uk-ux/inmoov-iris/hardware/assembly-references/head_32.png

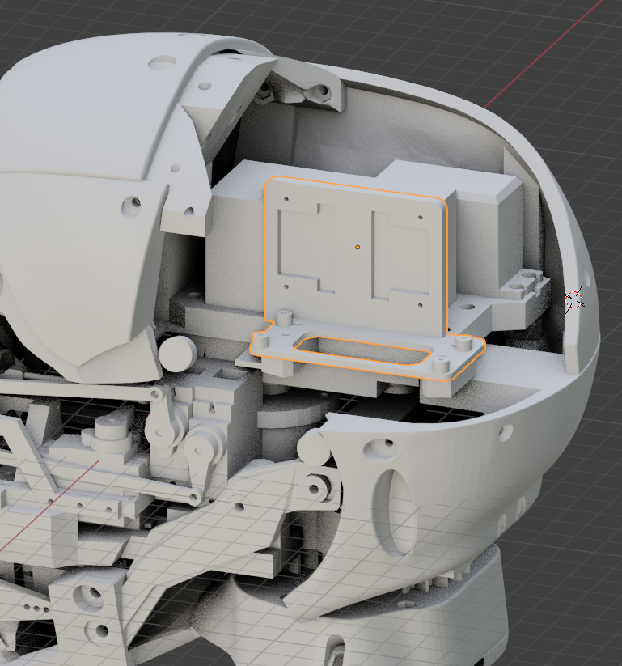
hardware/assembly-references/head_32.png
