uk-ux/inmoov-iris/hardware/assembly-references/head_11.png

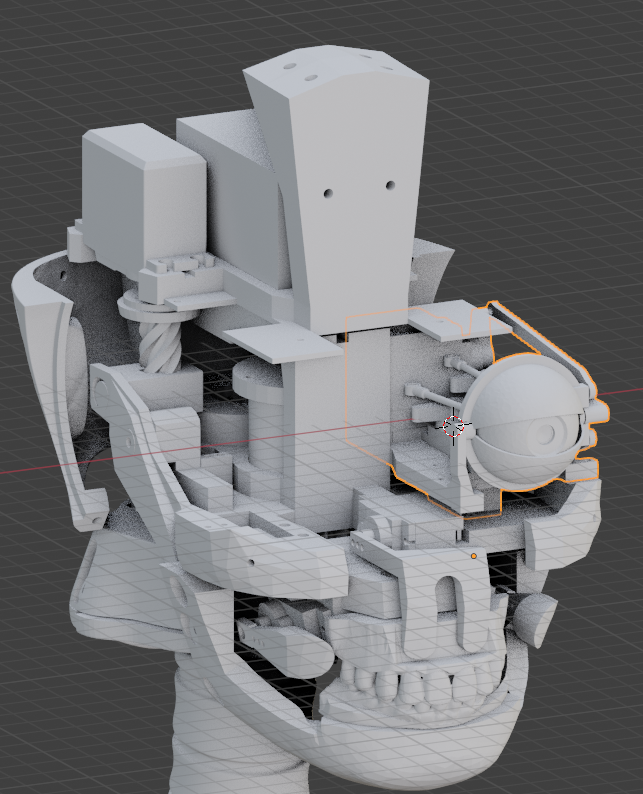
hardware/assembly-references/head_11.png
