uk-ux/inmoov-iris/hardware/i2eyes-source.html

# InMoov body parts library : i2Eyes

 (http://creativecommons.org/licenses/by-nc/3.0/)

INMOOV Eye-L-AllPartsV2.stl
Download Eye-L-AllPartsV2.stl

INMOOV Eye-L-BaseV5.stl
Download Eye-L-BaseV5.stl

INMOOV Eye-R-AllPartsV2.stl
Download Eye-R-AllPartsV2.stl

INMOOV Eye-R-BaseV5.stl
Download Eye-R-BaseV5.stl

### Press Release Discover InMoov Press Release all other the World (https://www.inmoov.fr/on-the-net/)
