uk-ux/inmoov-iris/hardware/i2head-source.html

# InMoov body parts library : i2Head

 (http://creativecommons.org/licenses/by-nc/3.0/)

INMOOV BottomTeethV1.stl
Download BottomTeethV1.stl

INMOOV CheekPullerV3.stl
Download CheekPullerV3.stl

INMOOV EarLockV1.stl
Download EarLockV1.stl

INMOOV EyebrowSupportV3.stl
Download EyebrowSupportV3.stl

INMOOV EyebrowV3.stl
Download EyebrowV3.stl

INMOOV FaceHolderLeftV5.stl
Download FaceHolderLeftV5.stl

INMOOV FaceHolderRightV5.stl
Download FaceHolderRightV5.stl

INMOOV ForHeadSupportV2.stl
Download ForHeadSupportV2.stl

INMOOV ForHeadsV4.stl
Download ForHeadsV4.stl

INMOOV GearHolderV3.stl
Download GearHolderV3.stl

INMOOV InnerMiddleMoldV1.stl
Download InnerMiddleMoldV1.stl

INMOOV InnerSidesMoldV1.stl
Download InnerSidesMoldV1.stl

INMOOV JawHingeV4.stl
Download JawHingeV4.stl

INMOOV JawPistonV1NoSupport.stl
Download JawPistonV1NoSupport.stl

INMOOV JawSupportV2.stl
Download JawSupportV2.stl

INMOOV JawV5.stl
Download JawV5.stl

INMOOV LowBackV5.stl
Download LowBackV5.stl

INMOOV MainGearV2.stl
Download MainGearV2.stl

INMOOV OuterBottomMoldFemaleV2.stl
Download OuterBottomMoldFemaleV2.stl

INMOOV OuterBottomMoldMaleV2.stl
Download OuterBottomMoldMaleV2.stl

INMOOV OuterTopMoldFemaleV1.stl
Download OuterTopMoldFemaleV1.stl

INMOOV OuterTopMoldMaleV1.stl
Download OuterTopMoldMaleV1.stl

INMOOV PCA9685ConnectV2.stl
Download PCA9685ConnectV2.stl

INMOOV PCA9685supportV1.stl
Download PCA9685supportV1.stl

INMOOV RingV2.stl
Download RingV2.stl

INMOOV ServoGearV2.stl
Download ServoGearV2.stl

INMOOV SkullServoFixV5.stl
Download SkullServoFixV5.stl

INMOOV TeethTopHolderV3.stl
Download TeethTopHolderV3.stl

INMOOV TopBackskullV4.stl
Download TopBackskullV4.stl

INMOOV TopTeethV3.stl
Download TopTeethV3.stl

INMOOV TopskullFrontV1.stl
Download TopskullFrontV1.stl

INMOOV TopskullV5.stl
Download TopskullV5.stl

INMOOV UpperLipV2.stl
Download UpperLipV2.stl

INMOOV servoAdapterV1.stl
Download servoAdapterV1.stl

INMOOV servoHornAdapterV1.stl
Download servoHornAdapterV1.stl

### Press Release Discover InMoov Press Release all other the World (https://www.inmoov.fr/on-the-net/)
