uk-ux/inmoov-iris/hardware/topskull-reference.png

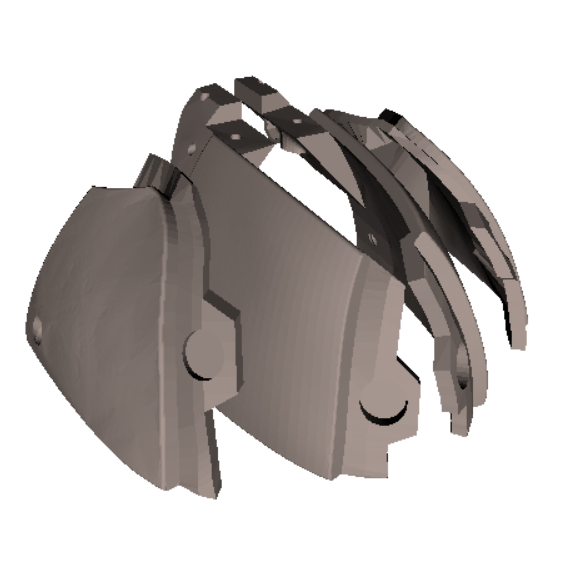
hardware/topskull-reference.png
