uk-ux/inmoov-iris/hardware/twin-isolate-preview.png

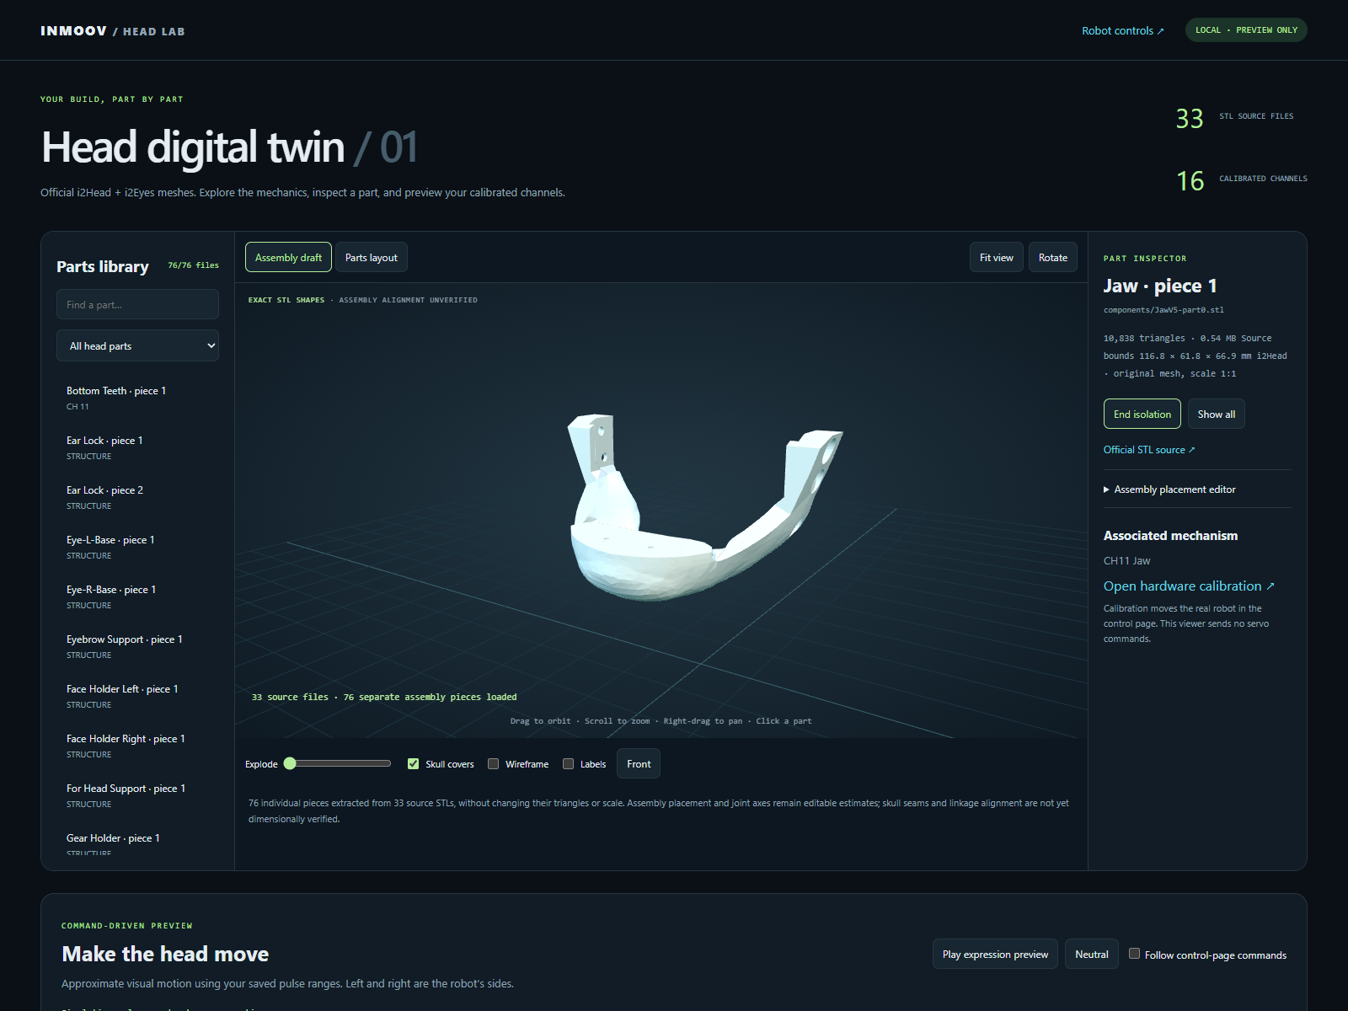
hardware/twin-isolate-preview.png
