uk-ux/inmoov-iris/hardware/twin-mobile-preview.png

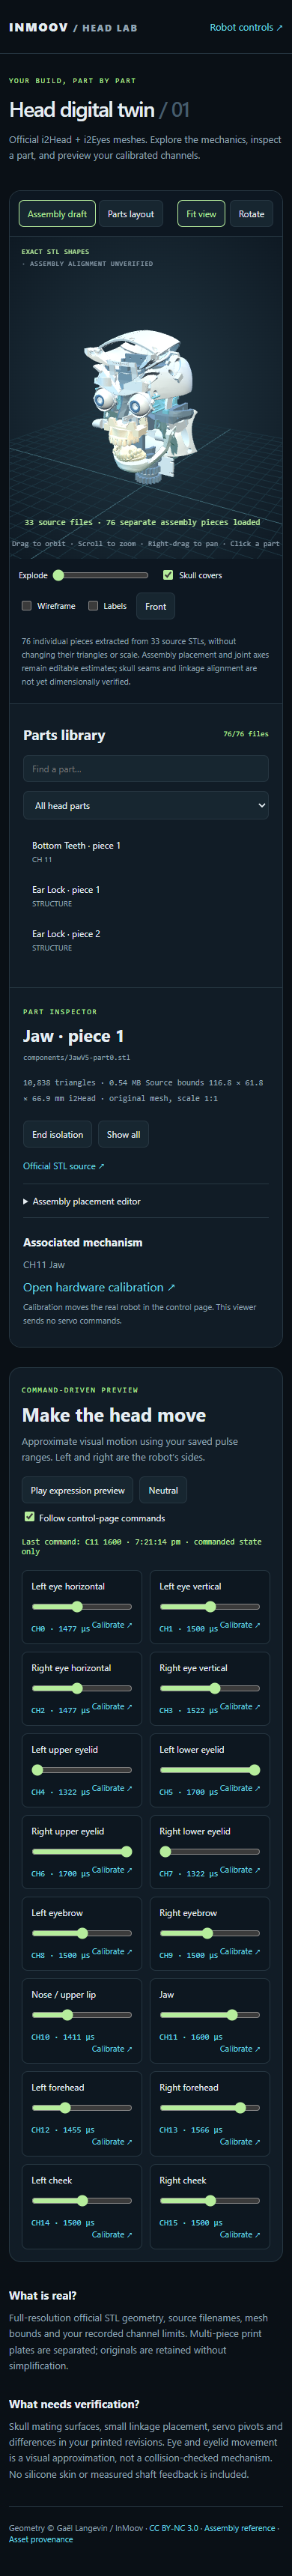
hardware/twin-mobile-preview.png
