uk-ux/inmoov-iris/hardware/twin-preview.png

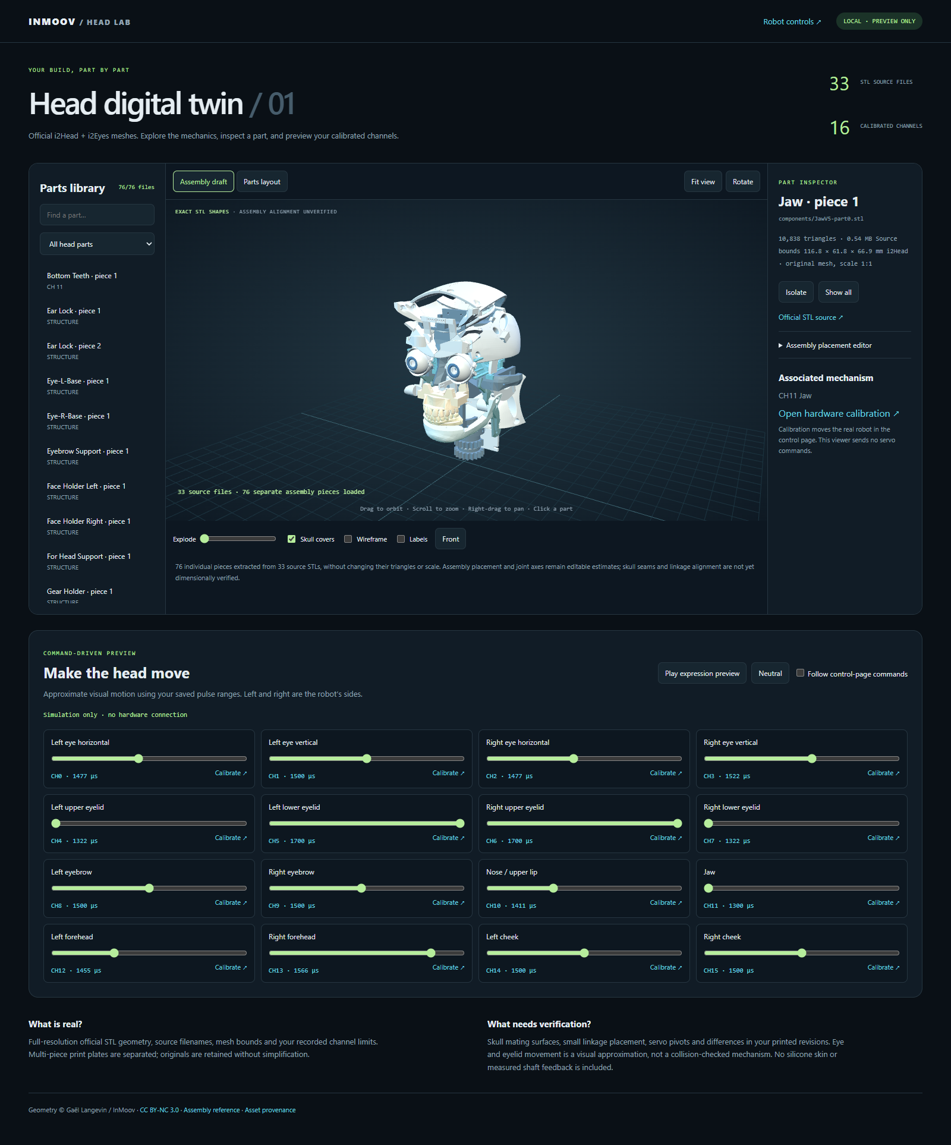
hardware/twin-preview.png
