uk-ux/inmoov-iris/hardware/component-inspect.png

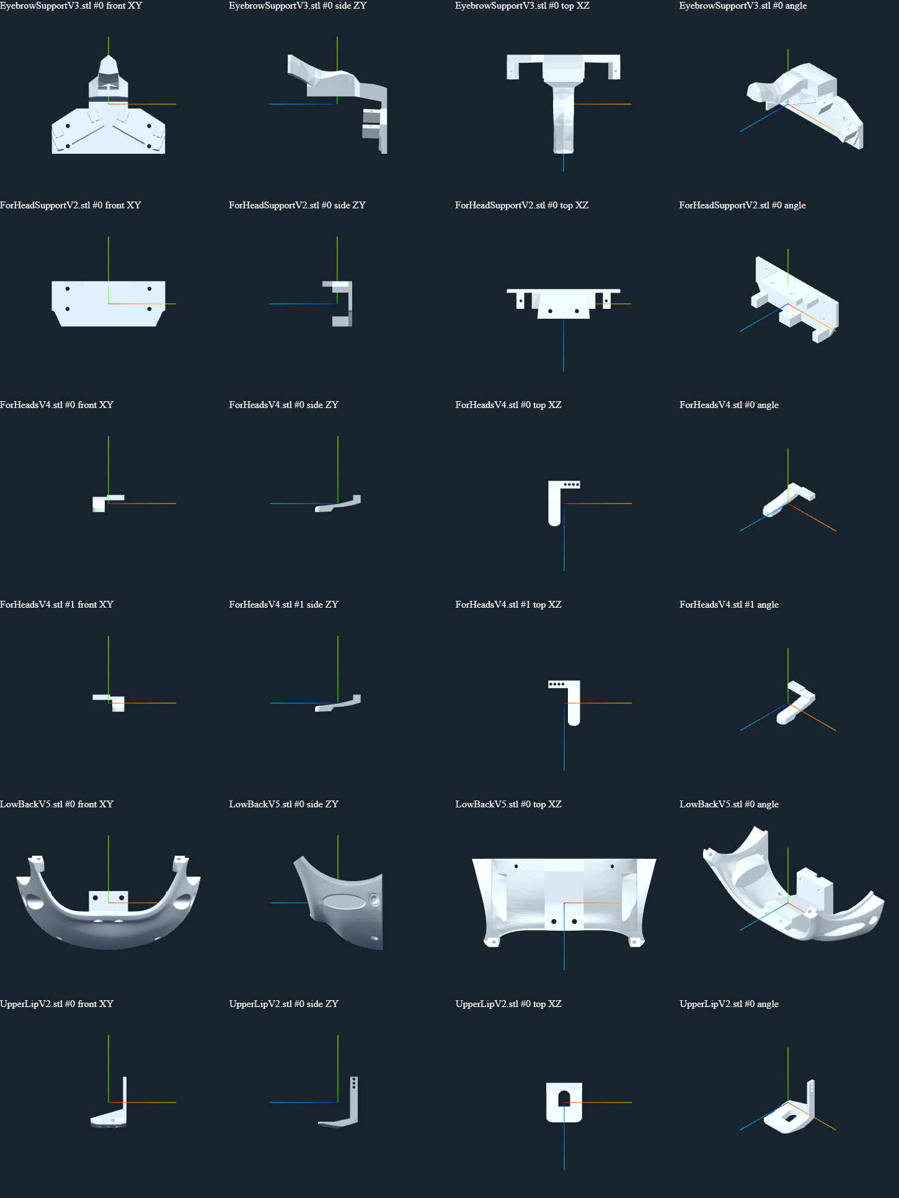
hardware/component-inspect.png
