uk-ux/inmoov-iris/control_ui/twin/assets/MainGearV2.stl

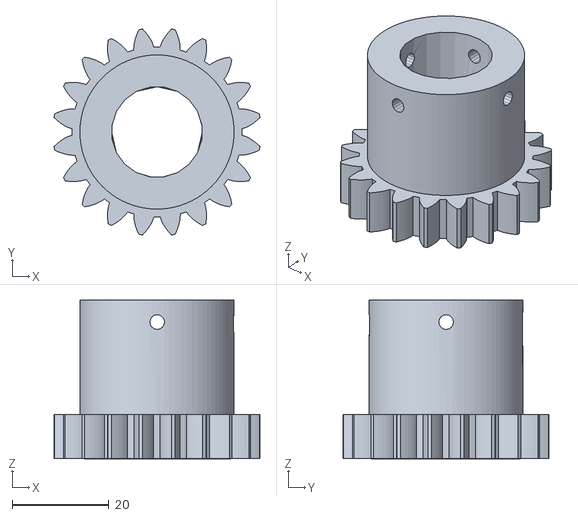
[picture p8: CAD file, 2026-09-29]
control_ui/twin/assets/MainGearV2.stl
42.7 x 42.7 x 32.8
