uk-ux/inmoov-iris/control_ui/twin/assets/components/Eye-R-AllPartsV2-part11.stl

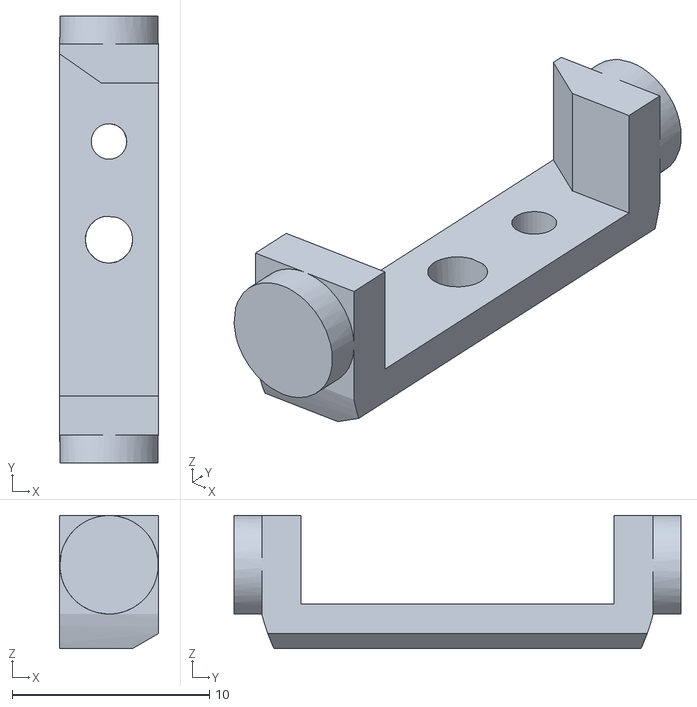
[picture p9: CAD file, 2026-09-29]
control_ui/twin/assets/components/Eye-R-AllPartsV2-part11.stl
5.00 x 22.7 x 6.75
