uk-ux/inmoov-iris/control_ui/twin/assets/PCA9685supportV1.stl

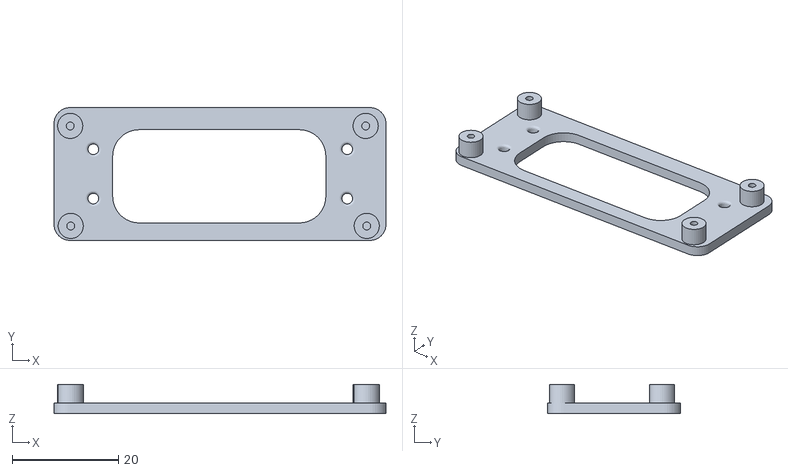
[picture p10: CAD file, 2026-09-29]
control_ui/twin/assets/PCA9685supportV1.stl
62.5 x 25.0 x 5.50
