uk-ux/inmoov-iris/control_ui/twin/assets/components/Eye-L-AllPartsV2-part7.stl

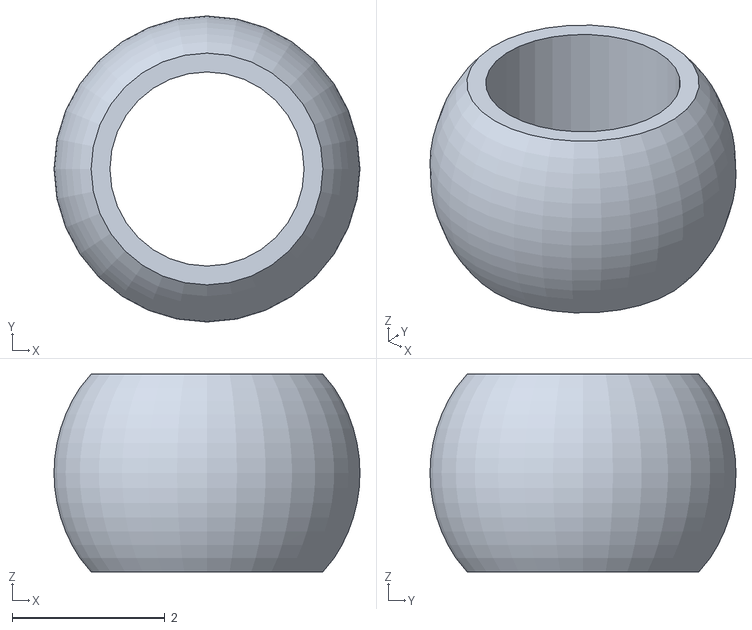
[picture p11: CAD file, 2026-09-29]
control_ui/twin/assets/components/Eye-L-AllPartsV2-part7.stl
4.00 x 4.00 x 2.59
