uk-ux/inmoov-iris/control_ui/twin/assets/LowBackV5.stl

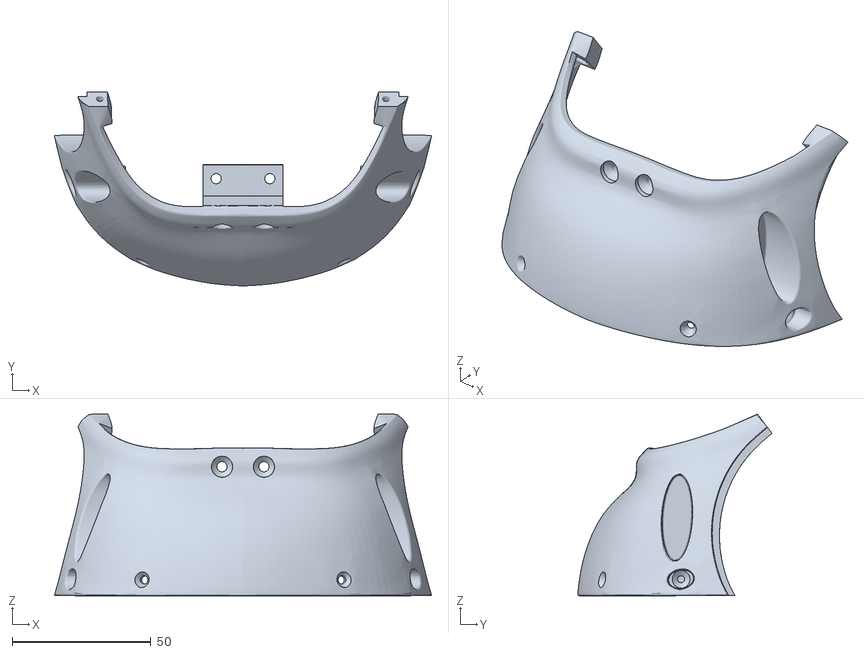
[picture p12: CAD file, 2026-09-29]
control_ui/twin/assets/LowBackV5.stl
136.1 x 70.0 x 65.6
