uk-ux/inmoov-iris/control_ui/twin/assets/components/JawV5-part0.stl

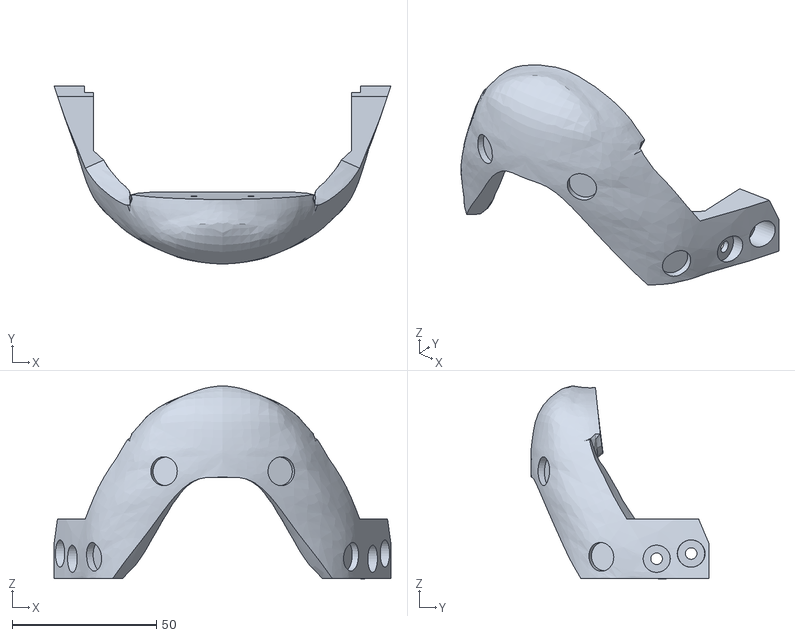
[picture p13: CAD file, 2026-09-29]
control_ui/twin/assets/components/JawV5-part0.stl
116.8 x 61.8 x 66.9
