uk-ux/inmoov-iris/control_ui/twin/assets/UpperLipV2.stl

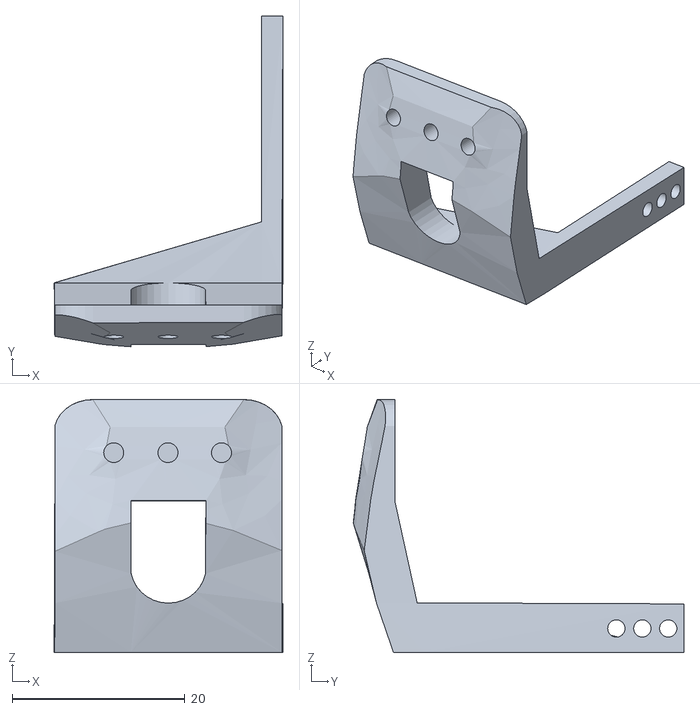
[picture p14: CAD file, 2026-09-29]
control_ui/twin/assets/UpperLipV2.stl
26.5 x 38.2 x 29.2
