uk-ux/inmoov-iris/control_ui/twin/assets/components/ForHeadsV4-part0.stl

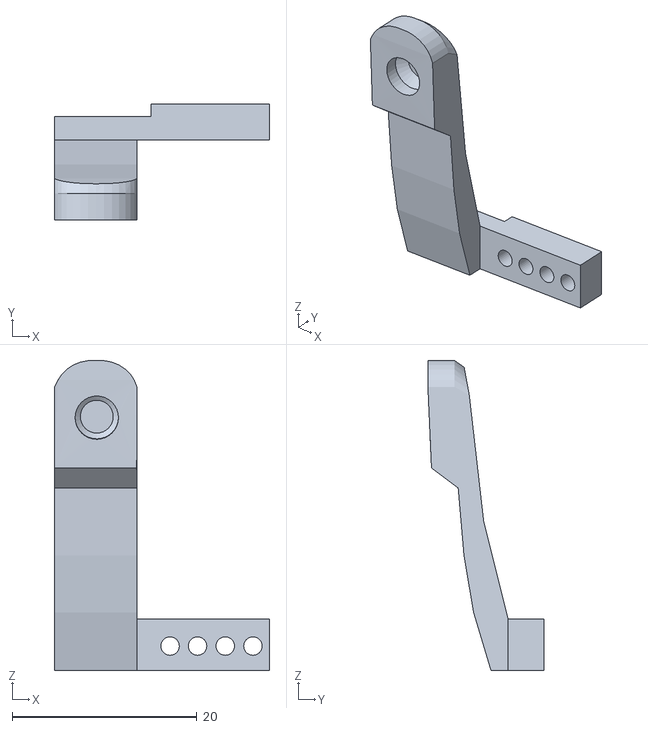
[picture p15: CAD file, 2026-09-29]
control_ui/twin/assets/components/ForHeadsV4-part0.stl
23.3 x 12.6 x 33.6
