uk-ux/inmoov-iris/control_ui/twin/assets/components/Eye-L-AllPartsV2-part10.stl

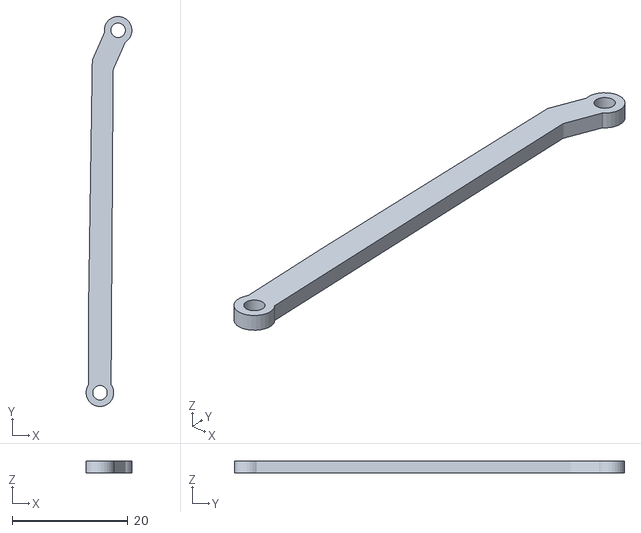
[picture p16: CAD file, 2026-09-29]
control_ui/twin/assets/components/Eye-L-AllPartsV2-part10.stl
7.92 x 67.4 x 2.00
