uk-ux/inmoov-iris/control_ui/twin/assets/RingV2.stl

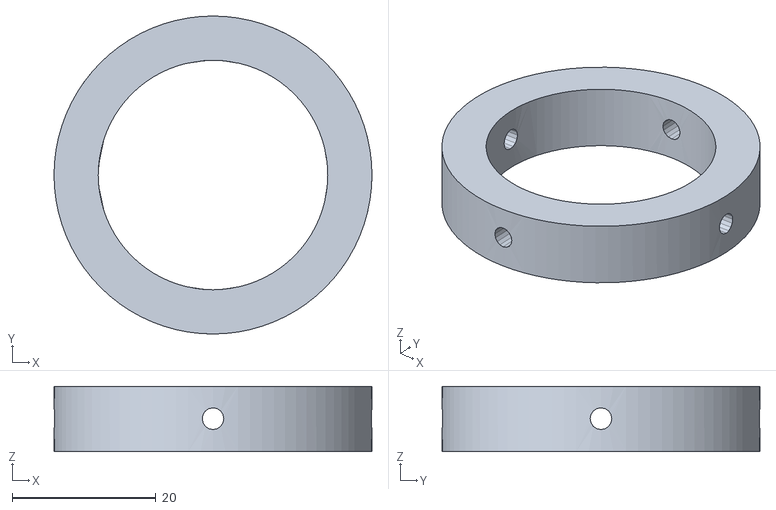
[picture p17: CAD file, 2026-09-29]
control_ui/twin/assets/RingV2.stl
44.3 x 44.3 x 9.08
