uk-ux/inmoov-iris/control_ui/twin/assets/components/Eye-R-AllPartsV2-part0.stl

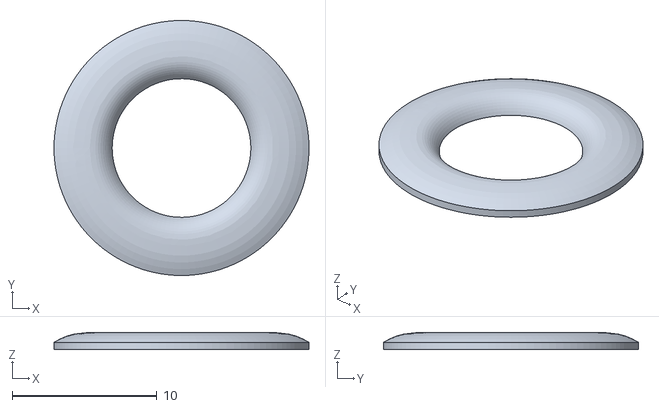
[picture p18: CAD file, 2026-09-29]
control_ui/twin/assets/components/Eye-R-AllPartsV2-part0.stl
17.6 x 17.6 x 1.18
