uk-ux/inmoov-iris/control_ui/twin/assets/TeethTopHolderV3.stl

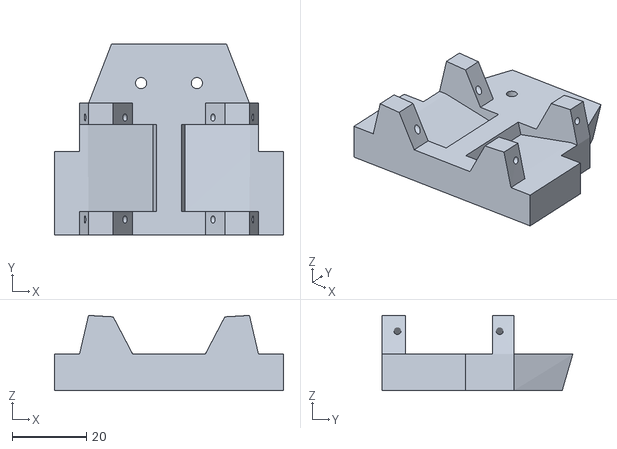
[picture p19: CAD file, 2026-09-29]
control_ui/twin/assets/TeethTopHolderV3.stl
61.6 x 51.3 x 20.2
