uk-ux/inmoov-iris/control_ui/twin/assets/components/Eye-L-AllPartsV2-part1.stl

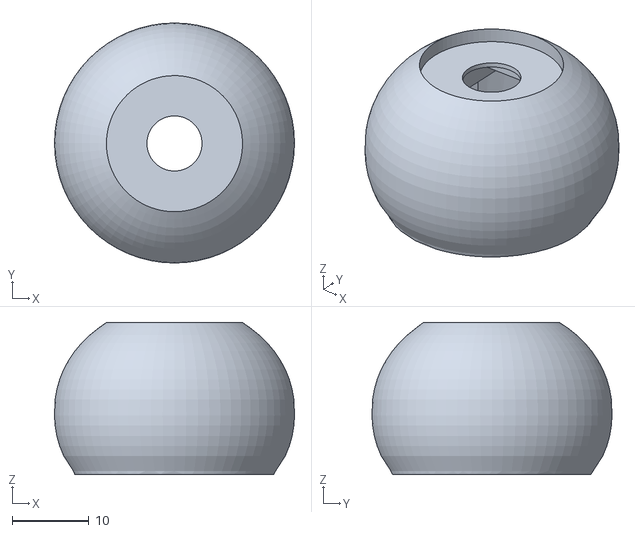
[picture p20: CAD file, 2026-09-29]
control_ui/twin/assets/components/Eye-L-AllPartsV2-part1.stl
31.4 x 31.4 x 19.9
