uk-ux/inmoov-iris/control_ui/twin/assets/servoAdapterV1.stl

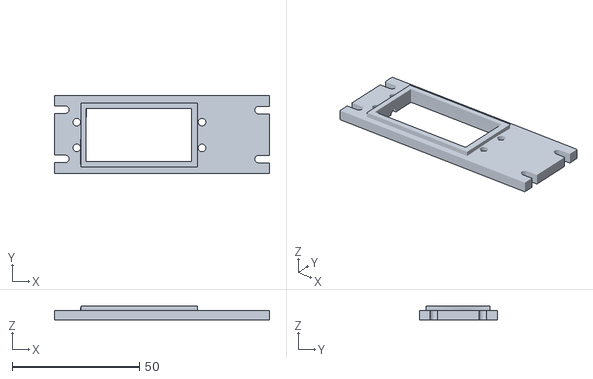
[picture p21: CAD file, 2026-09-29]
control_ui/twin/assets/servoAdapterV1.stl
84.4 x 30.5 x 5.48
