uk-ux/inmoov-iris/control_ui/twin/assets/Eye-L-BaseV5.stl

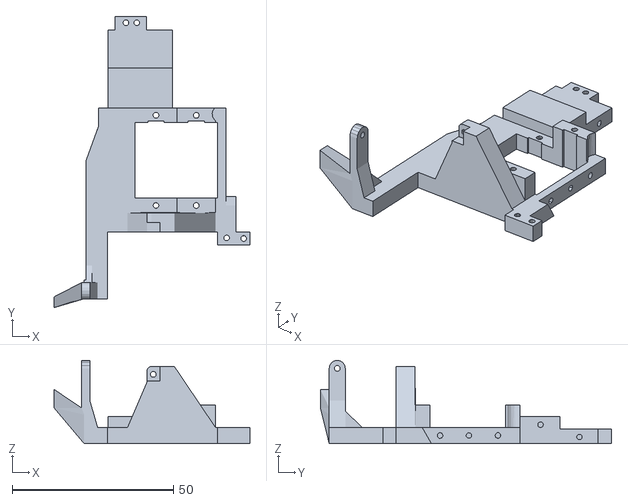
[picture p22: CAD file, 2026-09-29]
control_ui/twin/assets/Eye-L-BaseV5.stl
60.8 x 90.4 x 25.9
