uk-ux/inmoov-iris/control_ui/twin/assets/Eye-L-AllPartsV2.stl

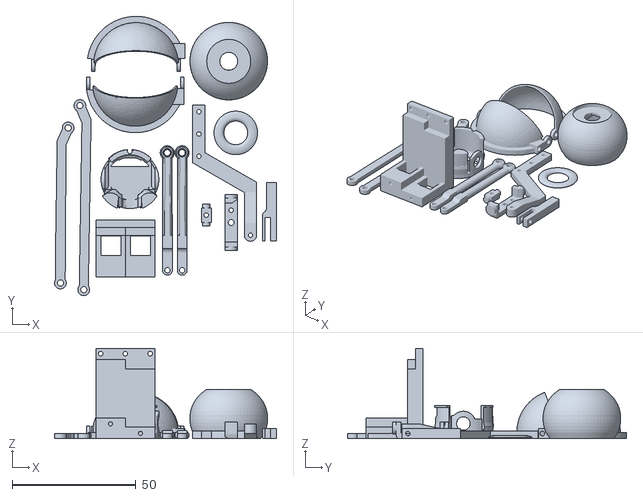
[picture p23: CAD file, 2026-09-29]
control_ui/twin/assets/Eye-L-AllPartsV2.stl
89.7 x 112.9 x 36.4
