uk-ux/inmoov-iris/control_ui/twin/assets/components/SkullServoFixV5-part0.stl

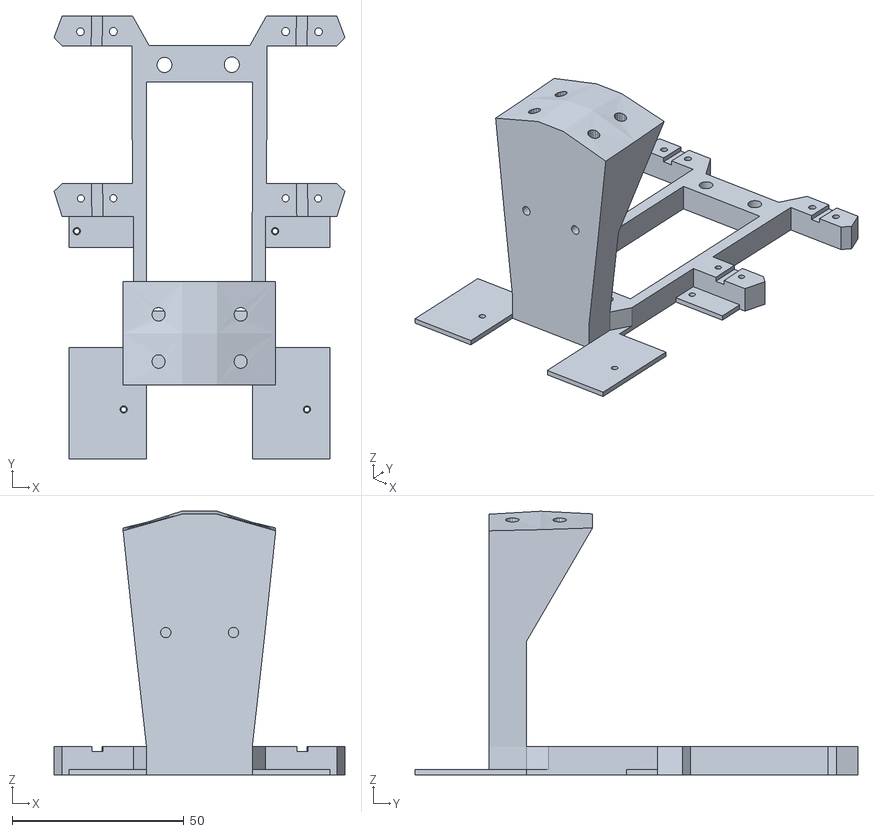
[picture p24: CAD file, 2026-09-29]
control_ui/twin/assets/components/SkullServoFixV5-part0.stl
84.6 x 128.8 x 76.7
