uk-ux/inmoov-iris/control_ui/twin/assets/JawPistonV1NoSupport.stl

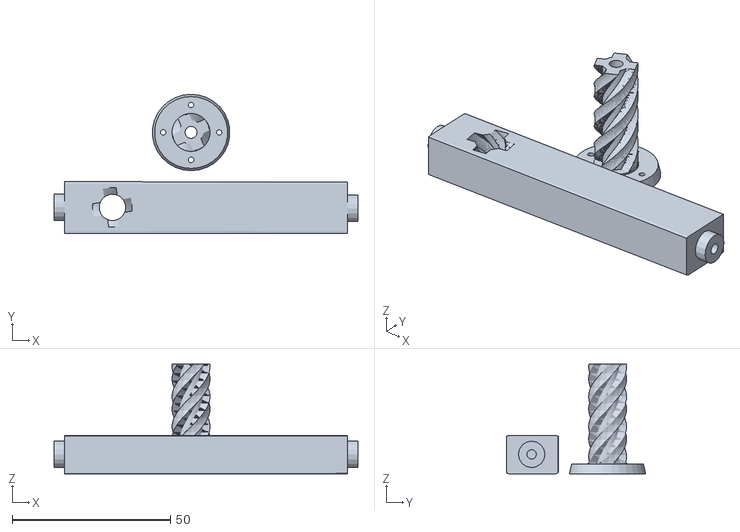
[picture p25: CAD file, 2026-09-29]
control_ui/twin/assets/JawPistonV1NoSupport.stl
96.0 x 44.0 x 34.6
