uk-ux/inmoov-iris/control_ui/twin/assets/GearHolderV3.stl

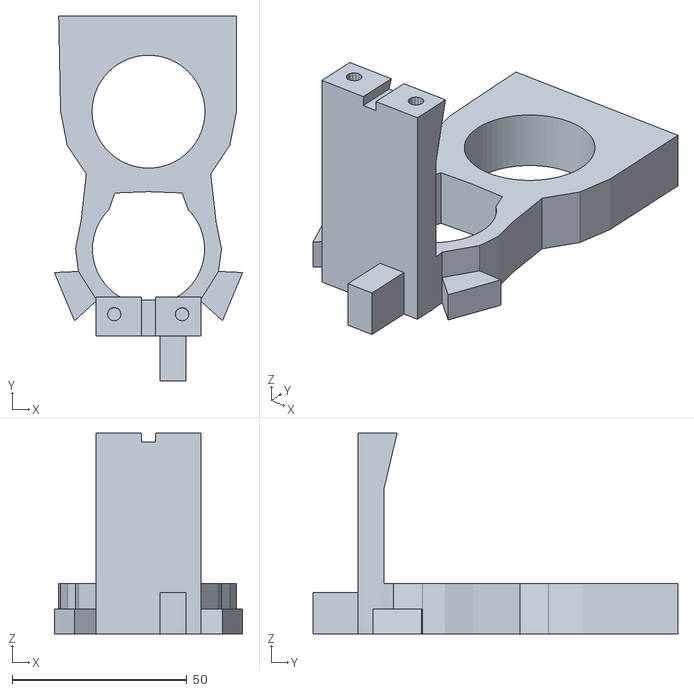
[picture p26: CAD file, 2026-09-29]
control_ui/twin/assets/GearHolderV3.stl
53.9 x 104.5 x 57.5
