uk-ux/inmoov-iris/control_ui/twin/assets/components/EyebrowSupportV3-part0.stl

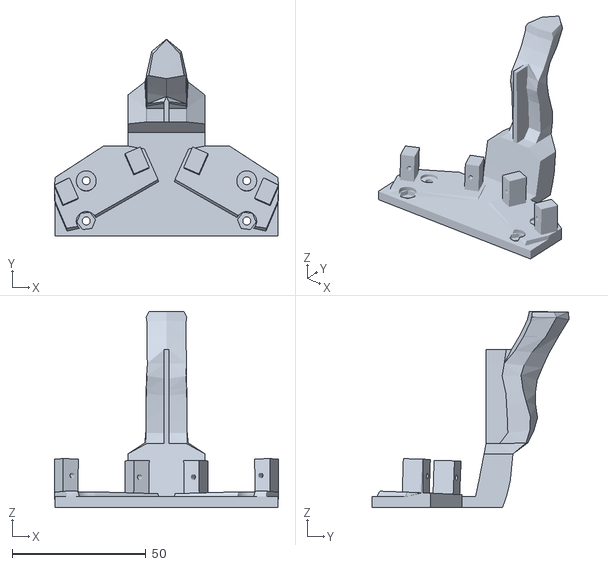
[picture p27: CAD file, 2026-09-29]
control_ui/twin/assets/components/EyebrowSupportV3-part0.stl
83.7 x 73.6 x 73.4
