uk-ux/inmoov-iris/control_ui/twin/assets/TopskullV5.stl

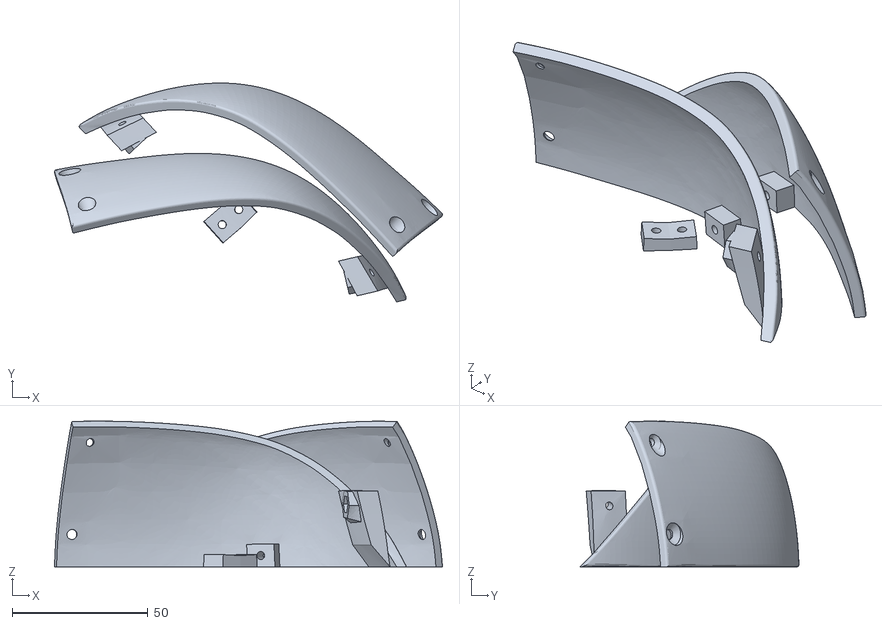
[picture p28: CAD file, 2026-09-29]
control_ui/twin/assets/TopskullV5.stl
142.7 x 80.5 x 53.6
