uk-ux/inmoov-iris/control_ui/twin/assets/TopTeethV3.stl

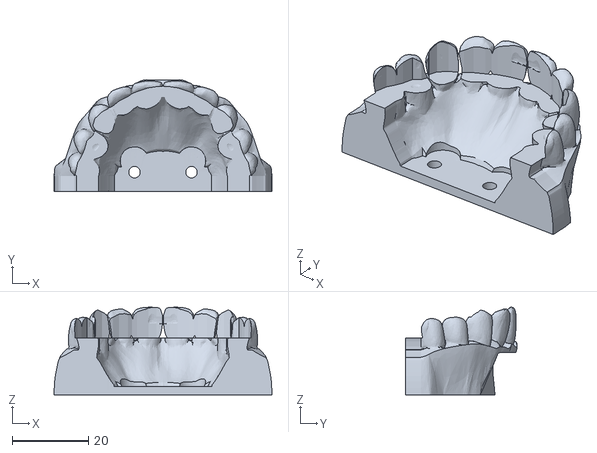
[picture p29: CAD file, 2026-09-29]
control_ui/twin/assets/TopTeethV3.stl
57.3 x 29.3 x 23.0
