uk-ux/inmoov-iris/control_ui/twin/assets/FaceHolderRightV5.stl

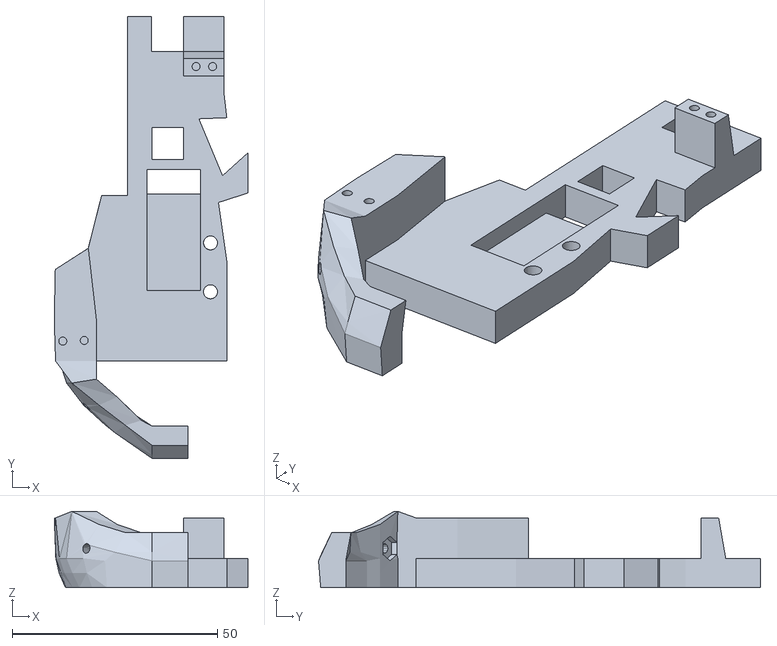
[picture p30: CAD file, 2026-09-29]
control_ui/twin/assets/FaceHolderRightV5.stl
47.2 x 107.8 x 18.6
