uk-ux/inmoov-iris/control_ui/twin/assets/components/EyebrowV3-part1.stl

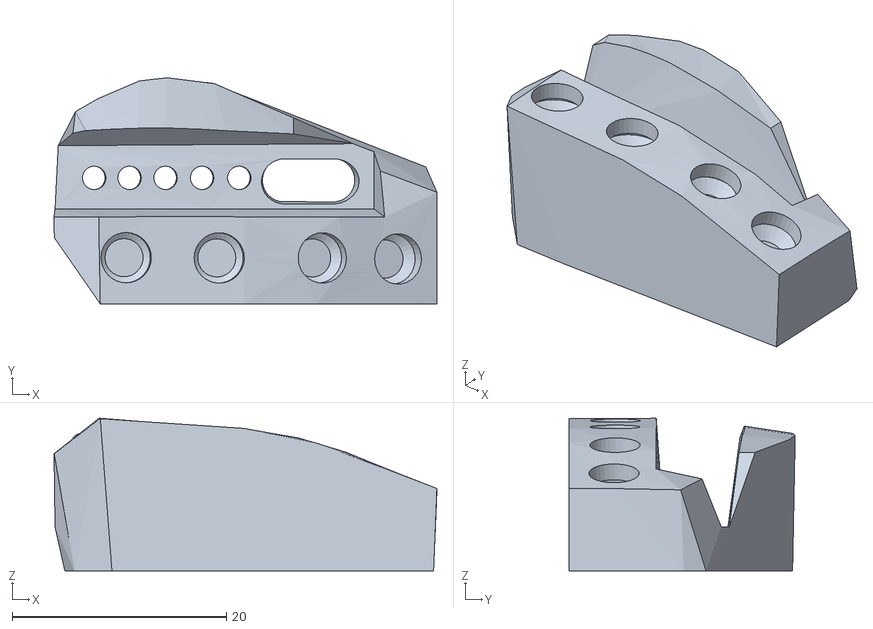
[picture p31: CAD file, 2026-09-29]
control_ui/twin/assets/components/EyebrowV3-part1.stl
35.8 x 21.1 x 14.3
