uk-ux/inmoov-iris/control_ui/twin/assets/ForHeadsV4.stl

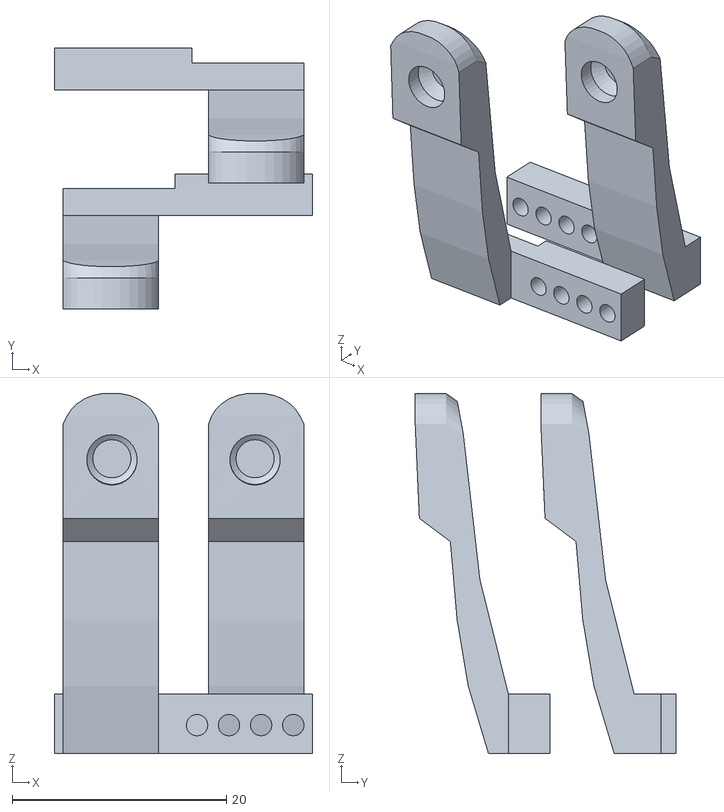
[picture p32: CAD file, 2026-09-29]
control_ui/twin/assets/ForHeadsV4.stl
24.1 x 24.3 x 33.6
