uk-ux/inmoov-iris/control_ui/twin/assets/BottomTeethV1.stl

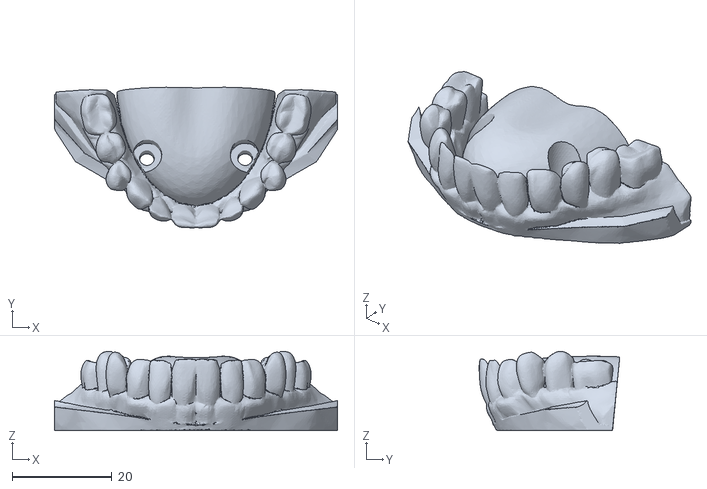
[picture p33: CAD file, 2026-09-29]
control_ui/twin/assets/BottomTeethV1.stl
56.7 x 28.2 x 15.9
