uk-ux/inmoov-iris/control_ui/twin/assets/components/TopskullV5-part0.stl

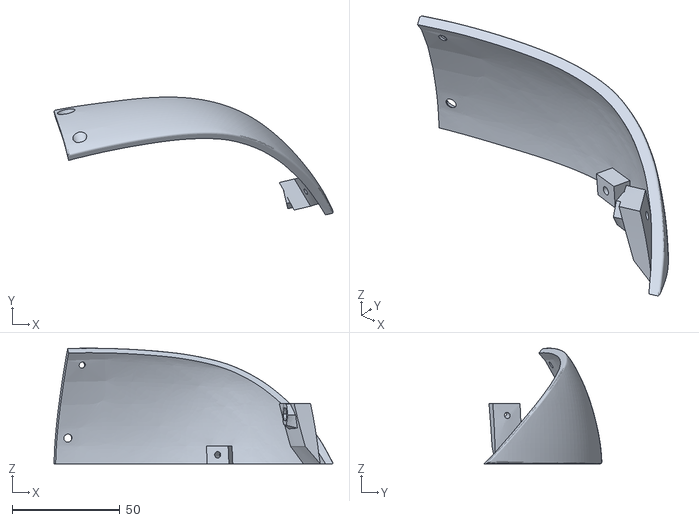
[picture p34: CAD file, 2026-09-29]
control_ui/twin/assets/components/TopskullV5-part0.stl
129.3 x 54.6 x 53.6
