uk-ux/inmoov-iris/control_ui/twin/assets/components/TopskullFrontV1-part1.stl

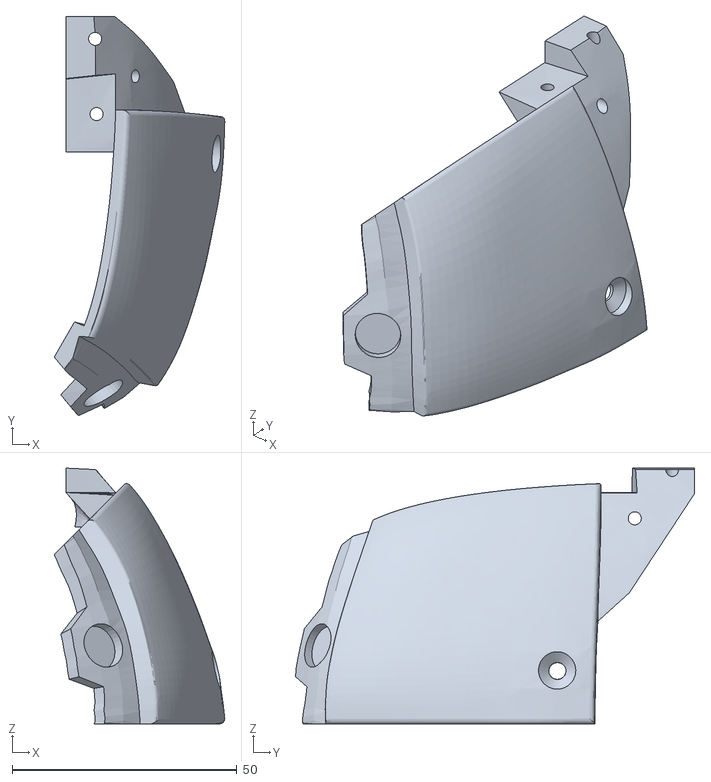
[picture p35: CAD file, 2026-09-29]
control_ui/twin/assets/components/TopskullFrontV1-part1.stl
38.0 x 88.8 x 56.9
