uk-ux/inmoov-iris/control_ui/twin/assets/servoHornAdapterV1.stl

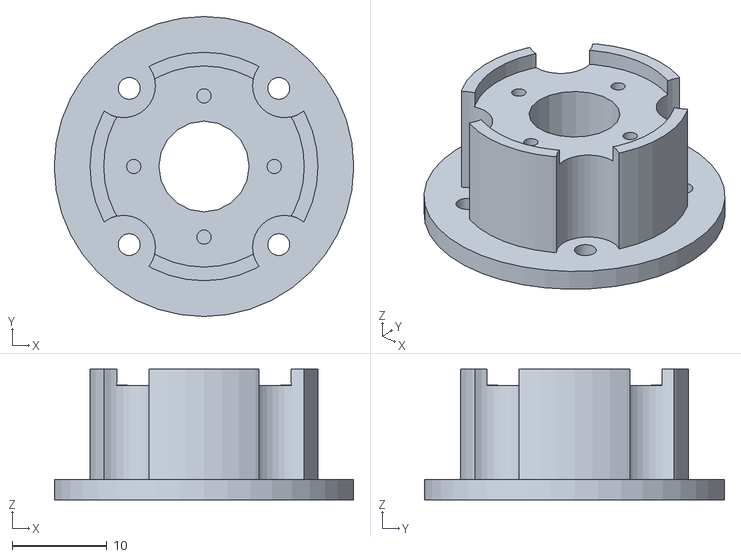
[picture p36: CAD file, 2026-09-29]
control_ui/twin/assets/servoHornAdapterV1.stl
31.5 x 31.6 x 13.8
