uk-ux/inmoov-iris/control_ui/twin/assets/CheekPullerV3.stl

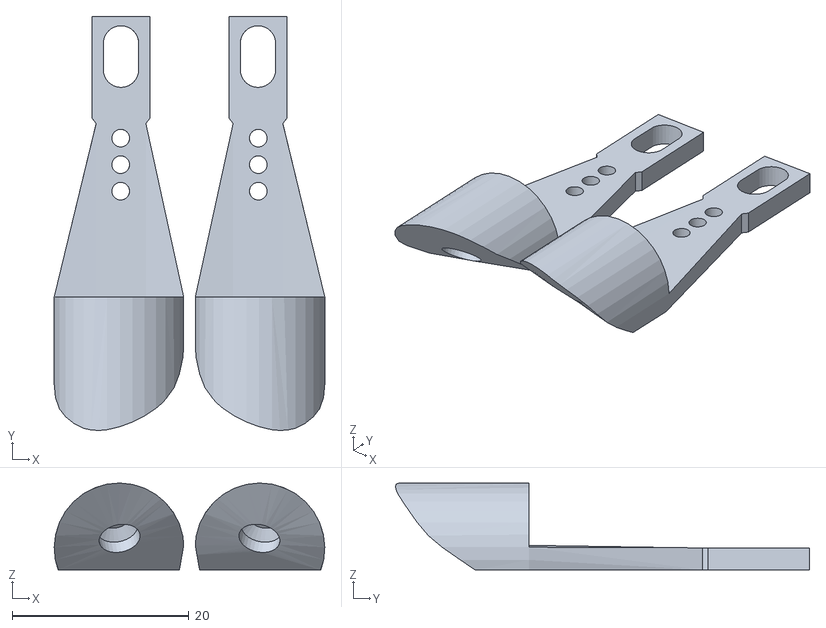
[picture p37: CAD file, 2026-09-29]
control_ui/twin/assets/CheekPullerV3.stl
30.6 x 46.9 x 9.84
