uk-ux/inmoov-iris/control_ui/twin/assets/components/Eye-L-AllPartsV2-part14.stl

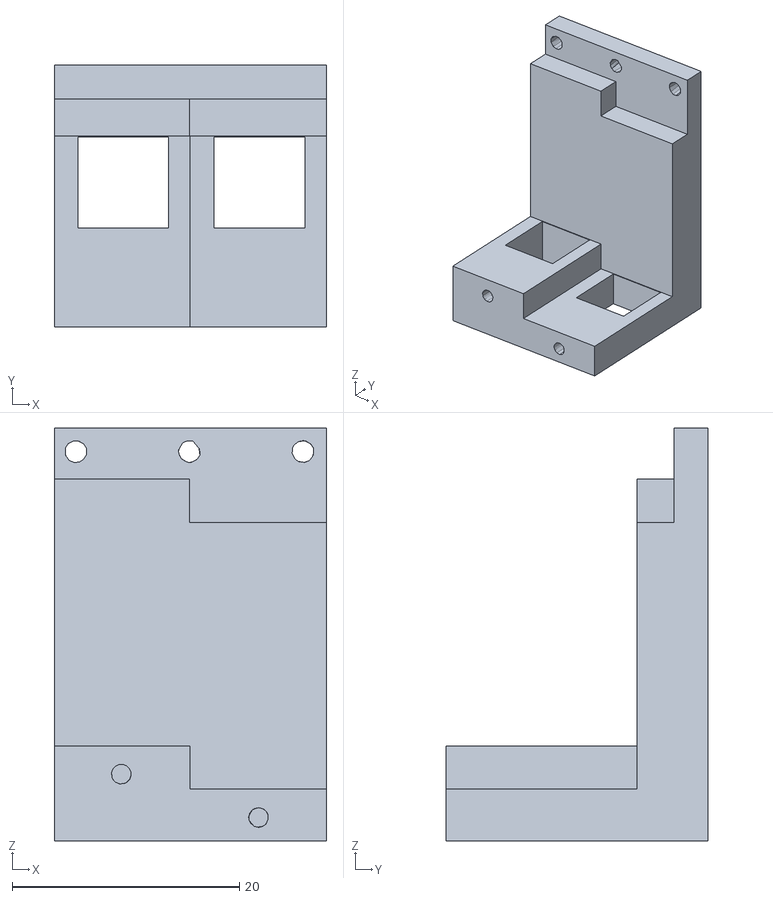
[picture p38: CAD file, 2026-09-29]
control_ui/twin/assets/components/Eye-L-AllPartsV2-part14.stl
24.0 x 23.0 x 36.4
