uk-ux/inmoov-iris/control_ui/twin/assets/components/Eye-R-AllPartsV2-part4.stl

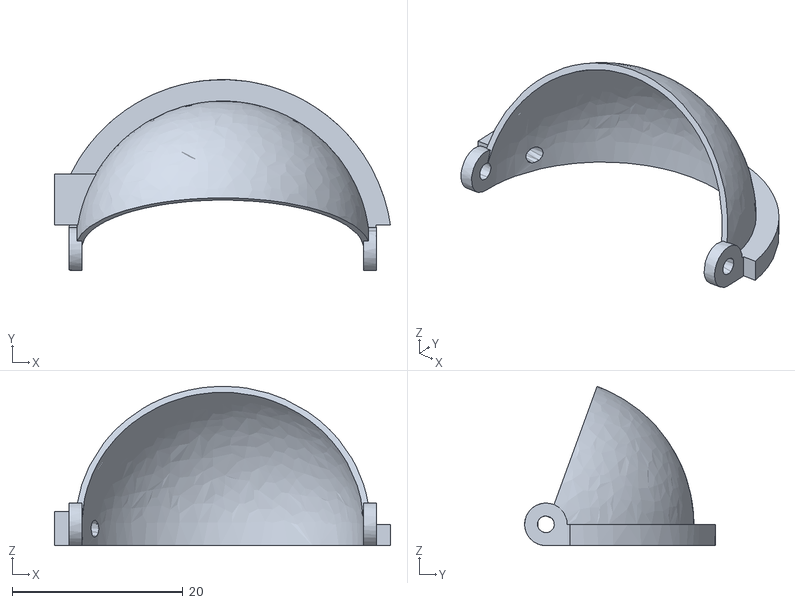
[picture p39: CAD file, 2026-09-29]
control_ui/twin/assets/components/Eye-R-AllPartsV2-part4.stl
39.4 x 22.3 x 18.7
