uk-ux/inmoov-iris/control_ui/twin/assets/PCA9685ConnectV2.stl

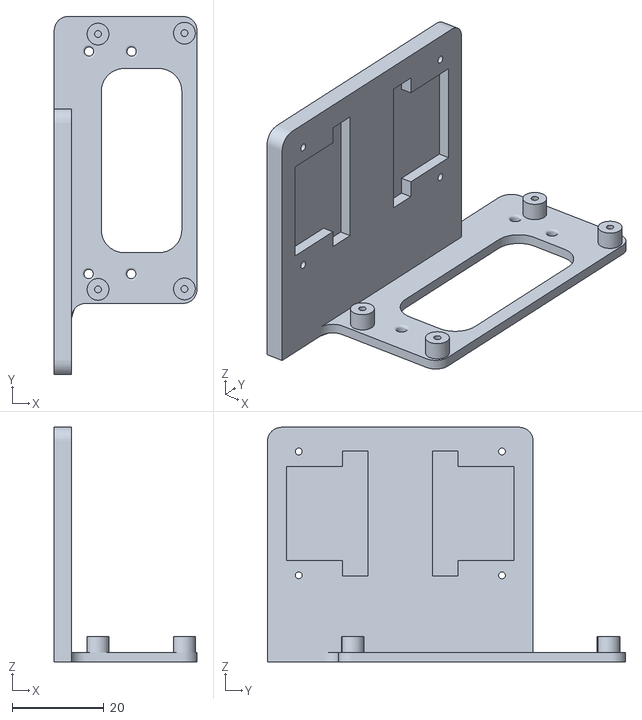
[picture p40: CAD file, 2026-09-29]
control_ui/twin/assets/PCA9685ConnectV2.stl
31.1 x 78.0 x 51.1
