uk-ux/inmoov-iris/control_ui/twin/assets/JawHingeV4.stl

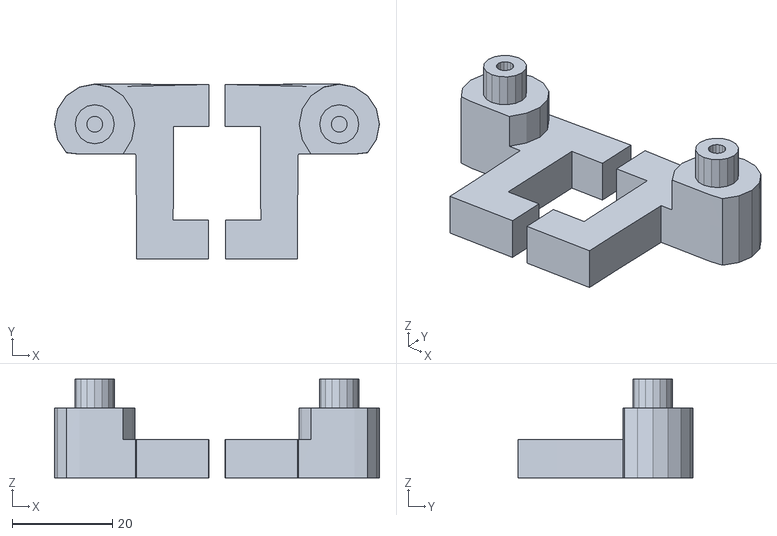
[picture p41: CAD file, 2026-09-29]
control_ui/twin/assets/JawHingeV4.stl
64.9 x 34.9 x 19.7
