uk-ux/inmoov-iris/control_ui/twin/assets/ServoGearV2.stl

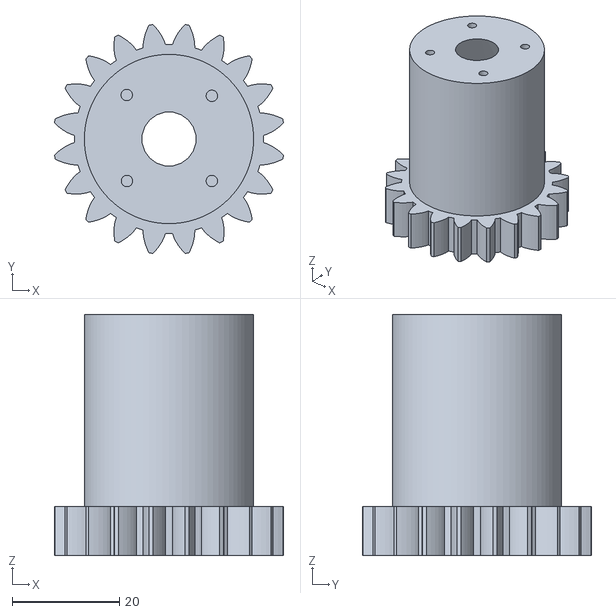
[picture p42: CAD file, 2026-09-29]
control_ui/twin/assets/ServoGearV2.stl
42.7 x 42.7 x 45.0
