uk-ux/inmoov-iris/control_ui/twin/assets/EarLockV1.stl

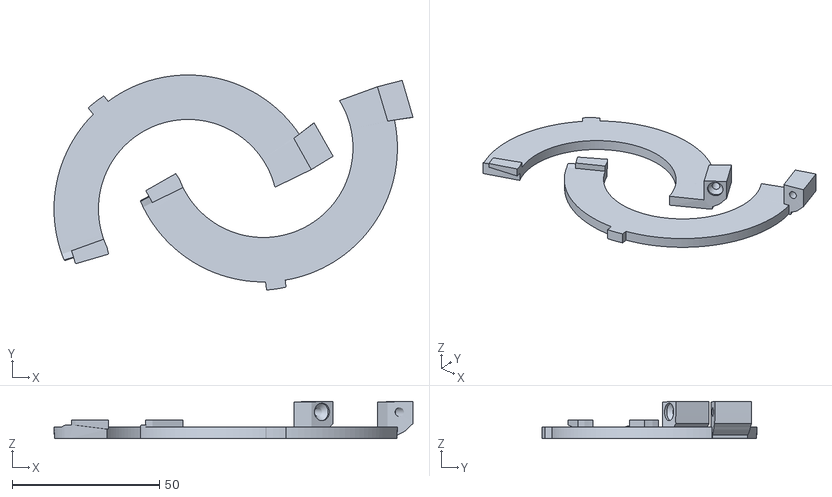
[picture p43: CAD file, 2026-09-29]
control_ui/twin/assets/EarLockV1.stl
121.9 x 73.0 x 12.7
