uk-ux/inmoov-iris/control_ui/twin/assets/components/FaceHolderLeftV5-part0.stl

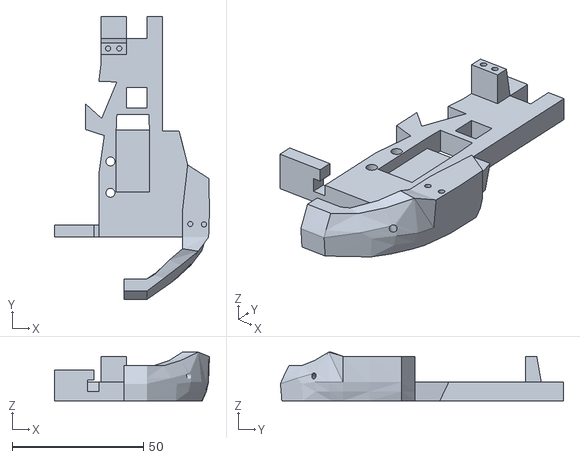
[picture p44: CAD file, 2026-09-29]
control_ui/twin/assets/components/FaceHolderLeftV5-part0.stl
59.0 x 107.8 x 18.6
