uk-ux/inmoov-iris/control_ui/twin/assets/JawSupportV2.stl

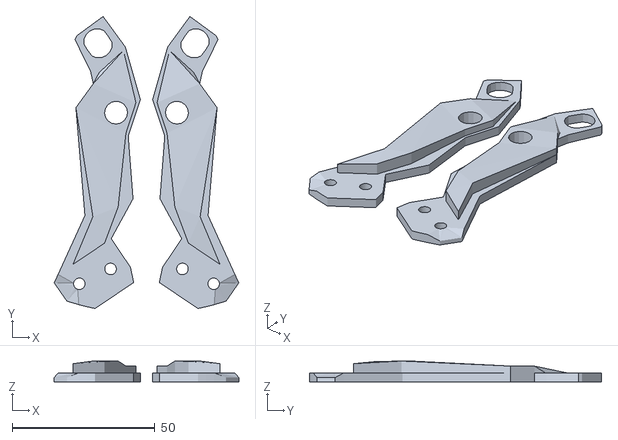
[picture p45: CAD file, 2026-09-29]
control_ui/twin/assets/JawSupportV2.stl
64.7 x 102.3 x 7.33
