uk-ux/inmoov-iris/control_ui/twin/assets/TopBackskullV4.stl

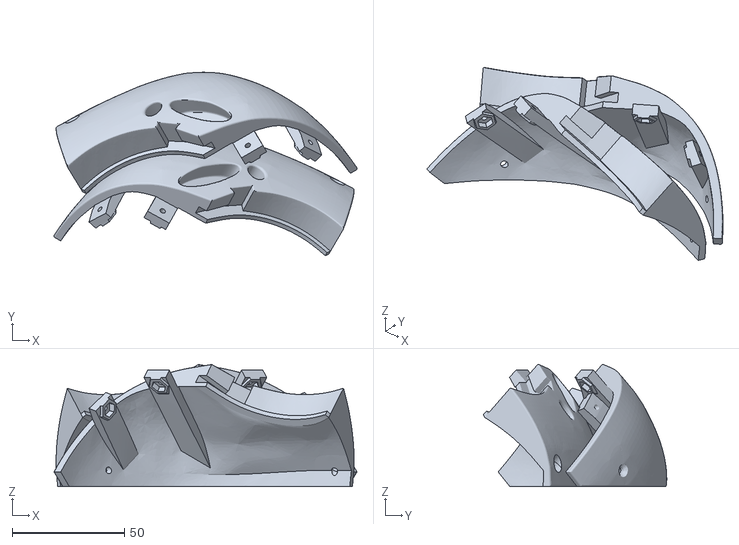
[picture p46: CAD file, 2026-09-29]
control_ui/twin/assets/TopBackskullV4.stl
134.9 x 81.7 x 54.3
