uk-ux/inmoov-iris/control_ui/twin/assets/components/Eye-L-AllPartsV2-part15.stl

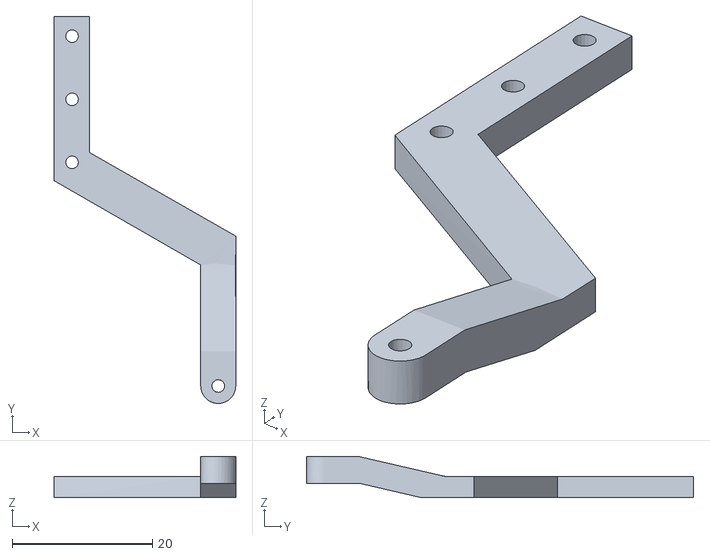
[picture p47: CAD file, 2026-09-29]
control_ui/twin/assets/components/Eye-L-AllPartsV2-part15.stl
25.9 x 55.2 x 5.85
