uk-ux/inmoov-iris/control_ui/twin/assets/components/Eye-R-AllPartsV2-part9.stl

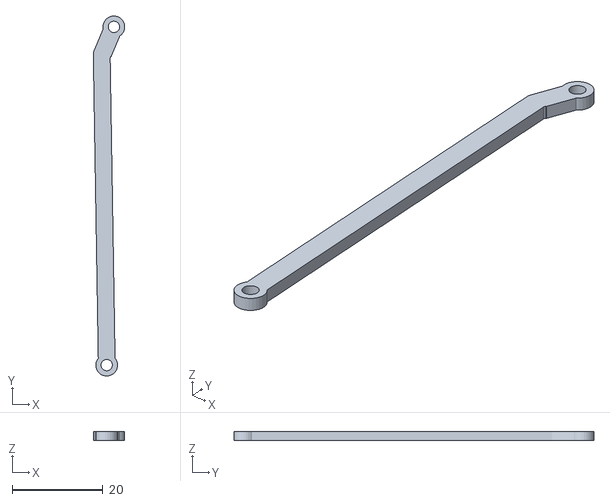
[picture p48: CAD file, 2026-09-29]
control_ui/twin/assets/components/Eye-R-AllPartsV2-part9.stl
6.92 x 79.2 x 2.00
