uk-ux/inmoov-iris/control_ui/twin/assets/ForHeadSupportV2.stl

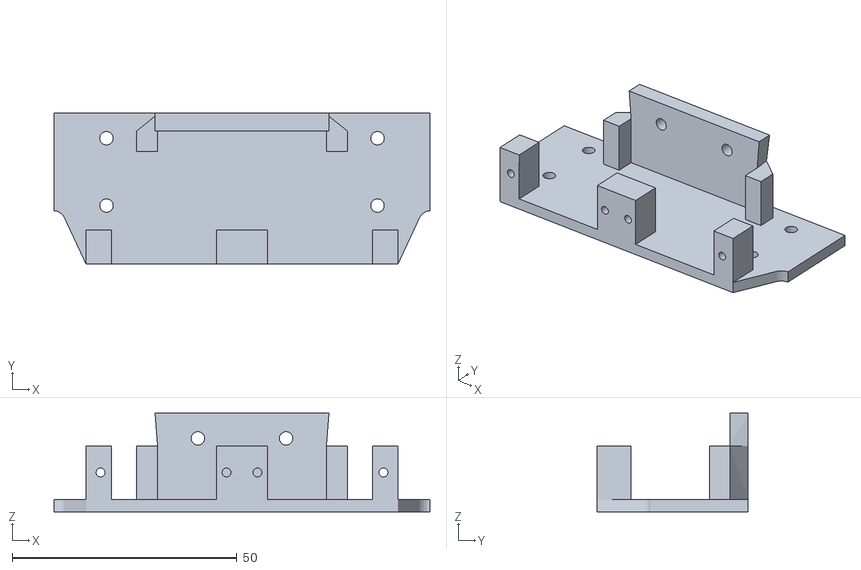
[picture p49: CAD file, 2026-09-29]
control_ui/twin/assets/ForHeadSupportV2.stl
83.7 x 33.6 x 22.0
