uk-ux/inmoov-iris/control_ui/twin/assets/components/Eye-R-AllPartsV2-part5.stl

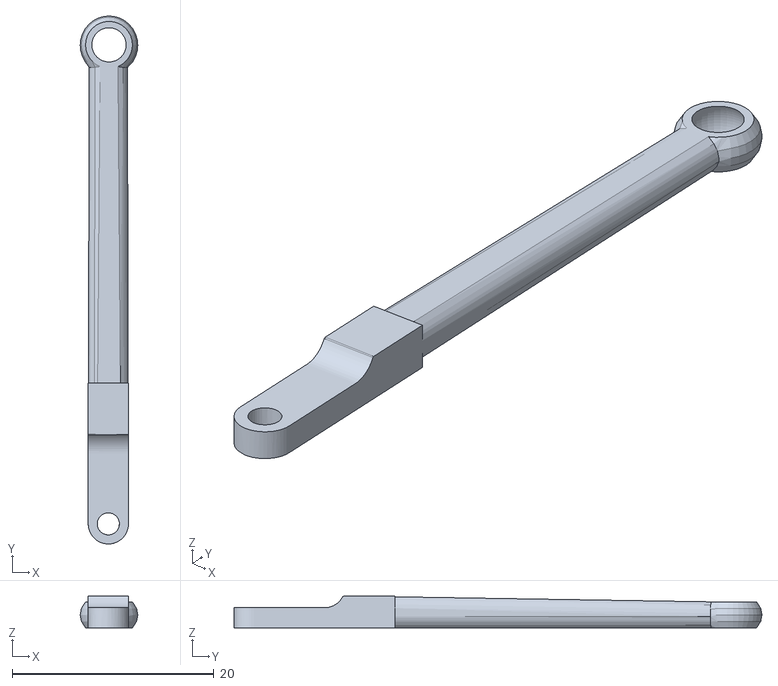
[picture p50: CAD file, 2026-09-29]
control_ui/twin/assets/components/Eye-R-AllPartsV2-part5.stl
5.72 x 52.4 x 3.15
