uk-ux/inmoov-iris/control_ui/twin/assets/components/JawSupportV2-part0.stl

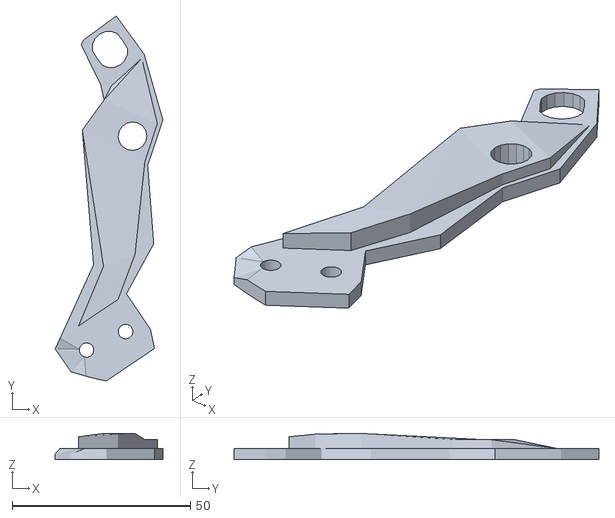
[picture p51: CAD file, 2026-09-29]
control_ui/twin/assets/components/JawSupportV2-part0.stl
30.2 x 102.3 x 7.33
