uk-ux/inmoov-iris/control_ui/twin/assets/TopskullFrontV1.stl

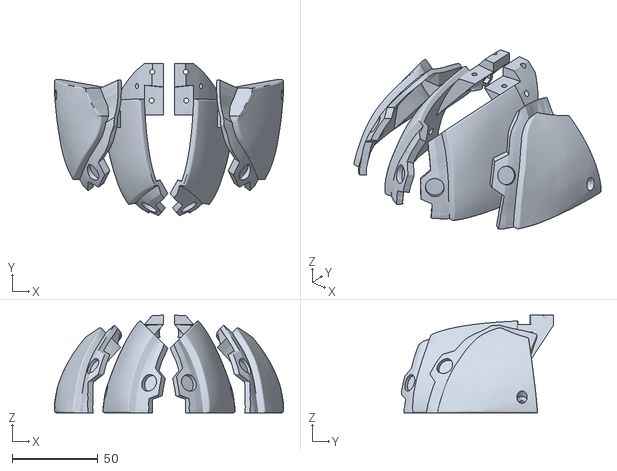
[picture p52: CAD file, 2026-09-29]
control_ui/twin/assets/TopskullFrontV1.stl
133.4 x 88.8 x 57.0
