uk-ux/inmoov-iris/control_ui/twin/assets/EyebrowV3.stl

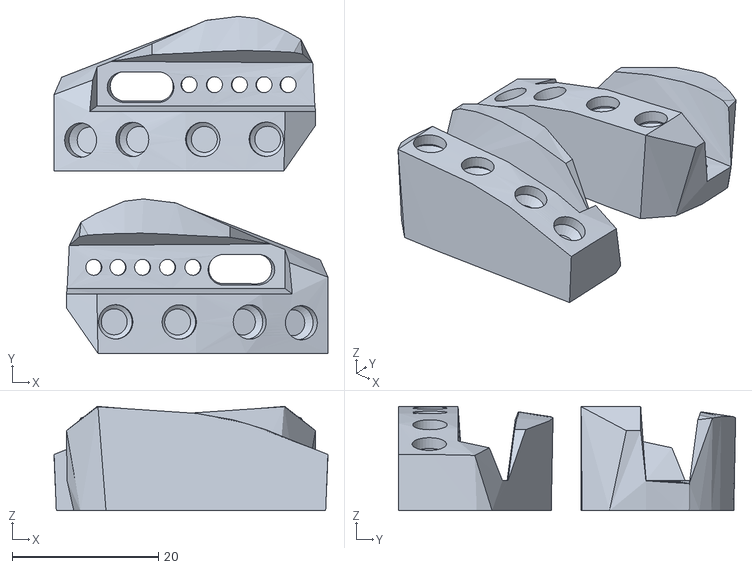
[picture p53: CAD file, 2026-09-29]
control_ui/twin/assets/EyebrowV3.stl
37.4 x 46.1 x 14.3
