uk-ux/inmoov-iris/control_ui/twin/assets/components/JawPistonV1NoSupport-part0.stl

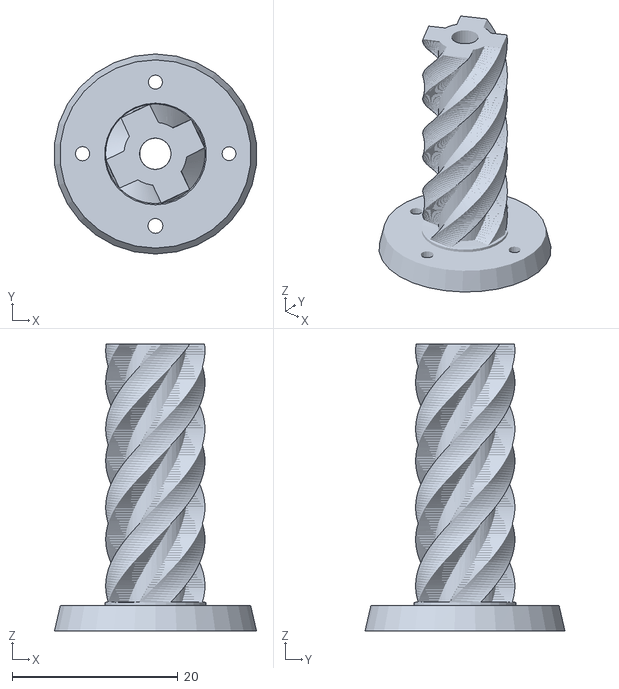
[picture p54: CAD file, 2026-09-29]
control_ui/twin/assets/components/JawPistonV1NoSupport-part0.stl
24.4 x 24.1 x 34.6
