uk-ux/inmoov-iris/control_ui/twin/assets/components/TopBackskullV4-part0.stl

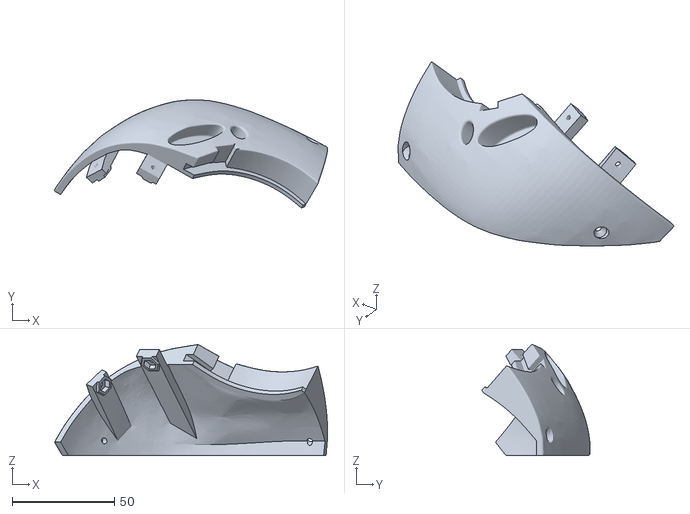
[picture p55: CAD file, 2026-09-29]
control_ui/twin/assets/components/TopBackskullV4-part0.stl
133.6 x 53.0 x 54.3
