uk-ux/inmoov-iris/control_ui/twin/assets/components/TopskullV5-part1.stl

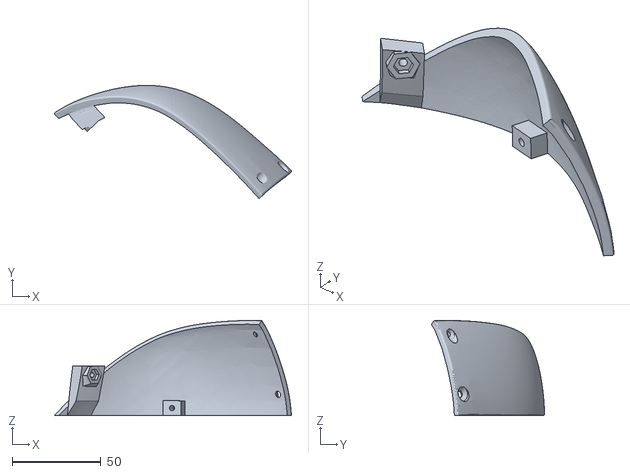
[picture p56: CAD file, 2026-09-29]
control_ui/twin/assets/components/TopskullV5-part1.stl
133.6 x 63.8 x 53.6
