uk-ux/inmoov-iris/control_ui/twin/assets/components/Eye-L-AllPartsV2-part12.stl

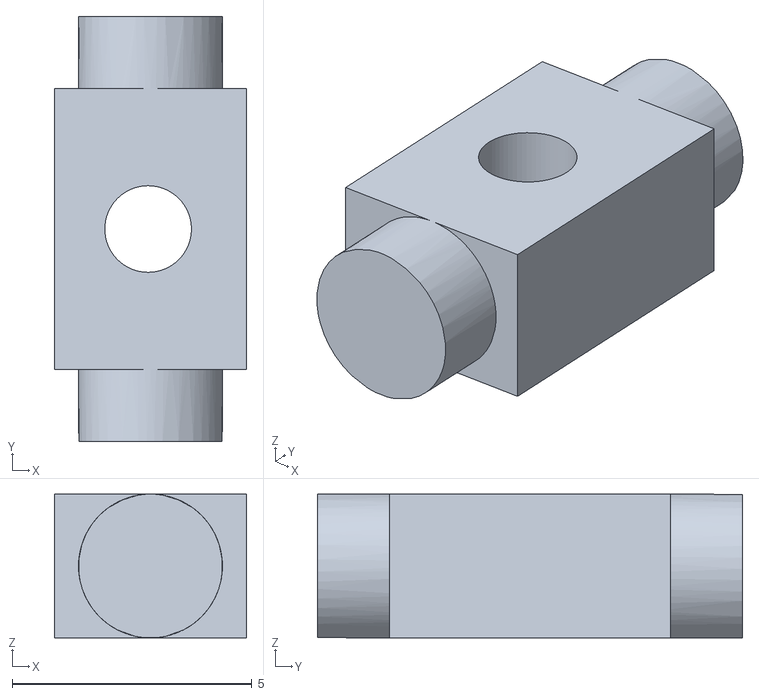
[picture p57: CAD file, 2026-09-29]
control_ui/twin/assets/components/Eye-L-AllPartsV2-part12.stl
4.00 x 8.86 x 3.00
