uk-ux/inmoov-iris/control_ui/twin/assets/components/JawHingeV4-part1.stl

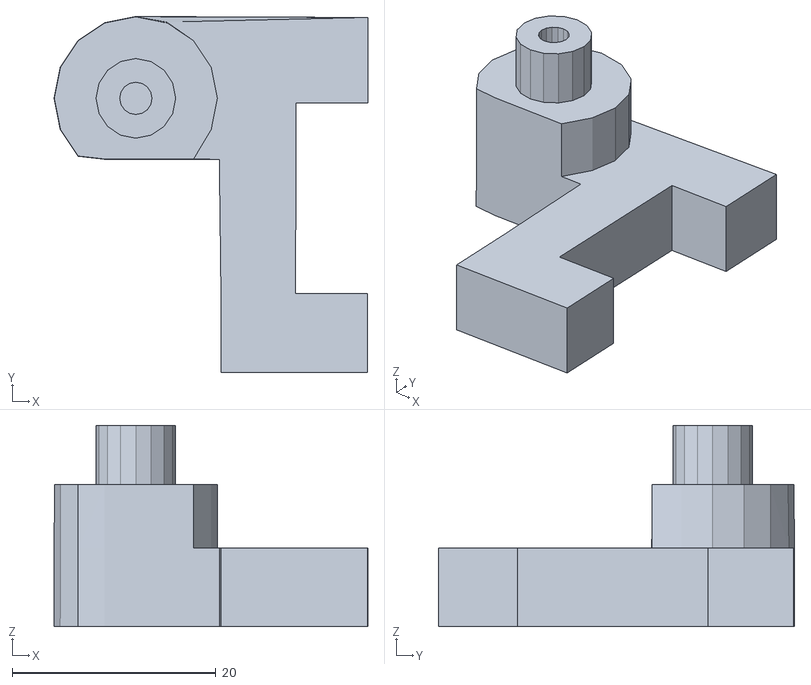
[picture p58: CAD file, 2026-09-29]
control_ui/twin/assets/components/JawHingeV4-part1.stl
30.8 x 34.9 x 19.7
