uk-ux/inmoov-iris/control_ui/twin/assets/components/JawPistonV1NoSupport-part1.stl

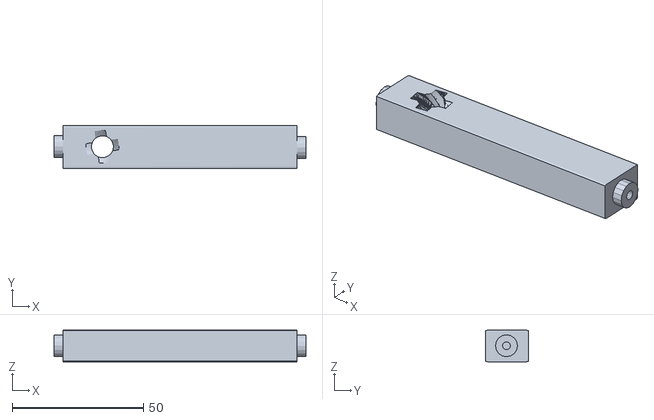
[picture p59: CAD file, 2026-09-29]
control_ui/twin/assets/components/JawPistonV1NoSupport-part1.stl
96.0 x 16.4 x 12.1
