uk-ux/inmoov-iris/control_ui/twin/assets/components/Eye-R-AllPartsV2-part13.stl

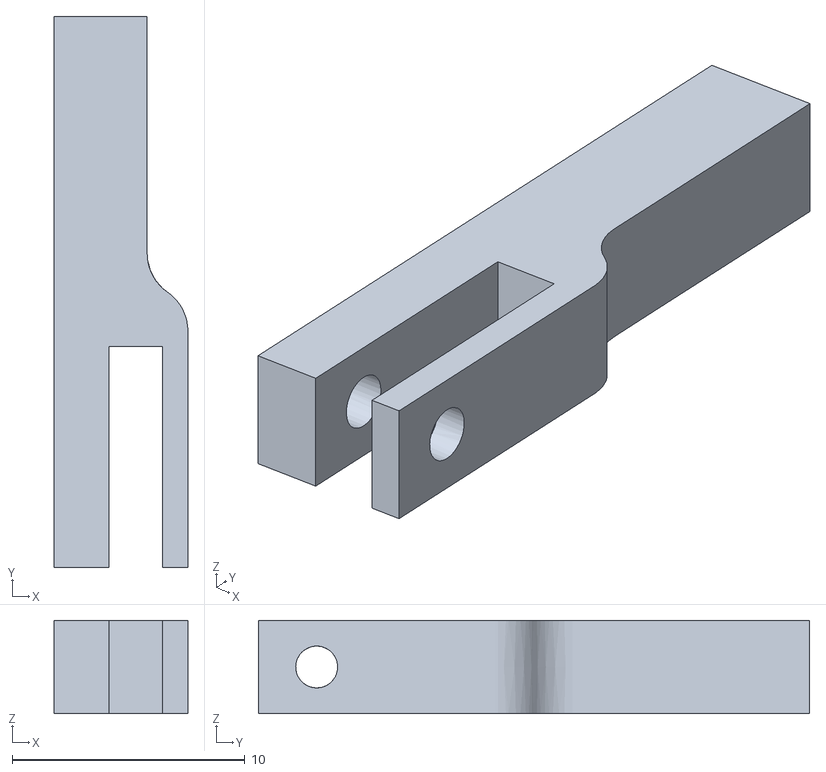
[picture p60: CAD file, 2026-09-29]
control_ui/twin/assets/components/Eye-R-AllPartsV2-part13.stl
5.75 x 23.7 x 4.00
