uk-ux/inmoov-iris/control_ui/twin/assets/components/TopskullV5-part2.stl

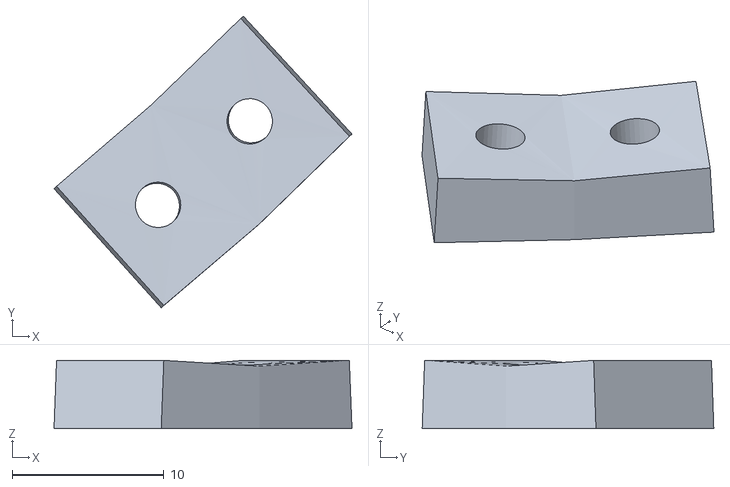
[picture p61: CAD file, 2026-09-29]
control_ui/twin/assets/components/TopskullV5-part2.stl
19.7 x 19.2 x 4.50
