uk-ux/inmoov-iris/control_ui/twin/assets/components/TopskullFrontV1-part2.stl

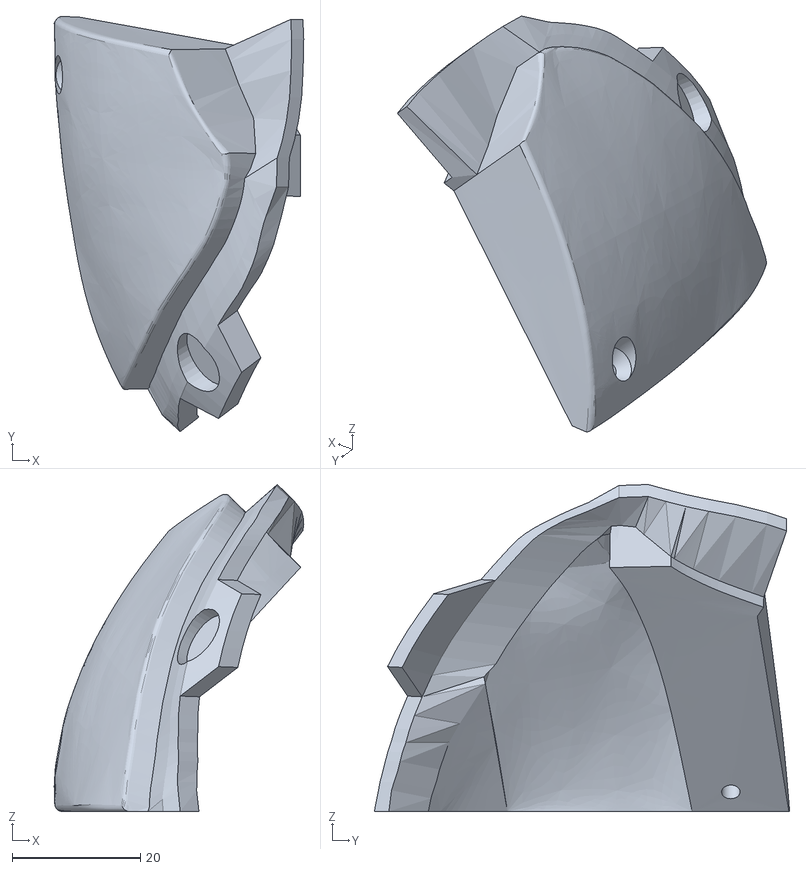
[picture p62: CAD file, 2026-09-29]
control_ui/twin/assets/components/TopskullFrontV1-part2.stl
39.0 x 64.9 x 51.1
