uk-ux/inmoov-iris/control_ui/twin/assets/components/TopBackskullV4-part1.stl

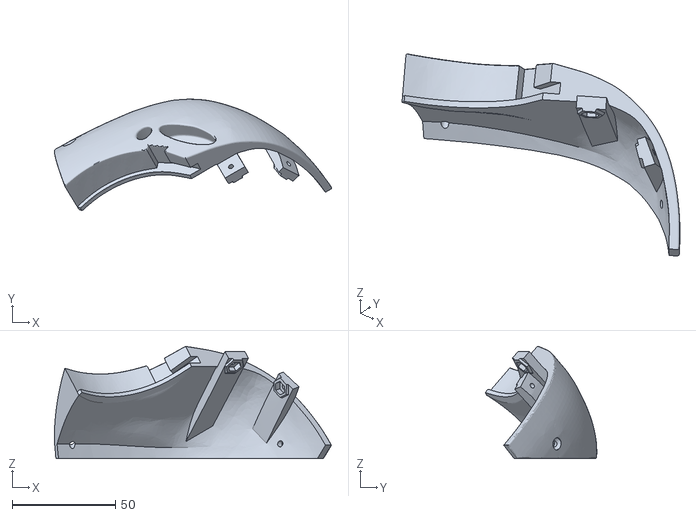
[picture p63: CAD file, 2026-09-29]
control_ui/twin/assets/components/TopBackskullV4-part1.stl
134.0 x 54.0 x 54.3
