uk-ux/inmoov-iris/control_ui/twin/assets/components/CheekPullerV3-part1.stl

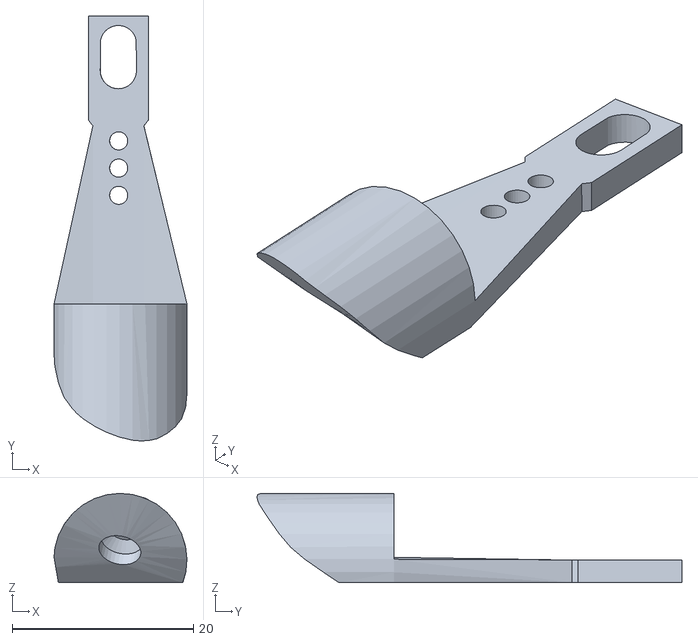
[picture p64: CAD file, 2026-09-29]
control_ui/twin/assets/components/CheekPullerV3-part1.stl
14.7 x 46.9 x 9.84
