uk-ux/inmoov-iris/control_ui/twin/assets/components/Eye-R-AllPartsV2-part2.stl

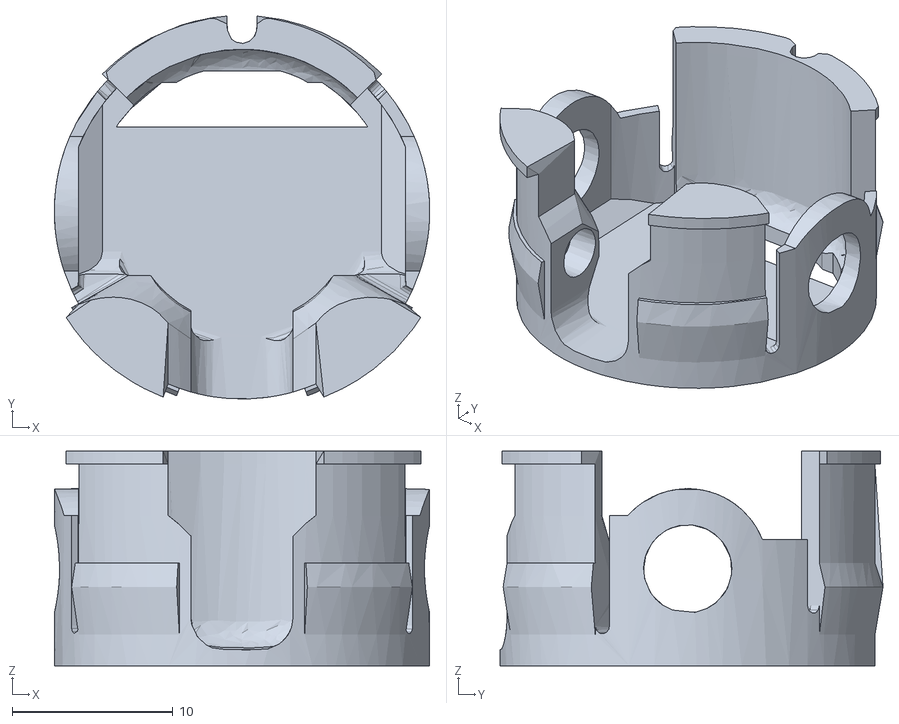
[picture p65: CAD file, 2026-09-29]
control_ui/twin/assets/components/Eye-R-AllPartsV2-part2.stl
23.4 x 23.9 x 13.4
