uk-ux/inmoov-iris/control_ui/twin/assets/components/EarLockV1-part1.stl

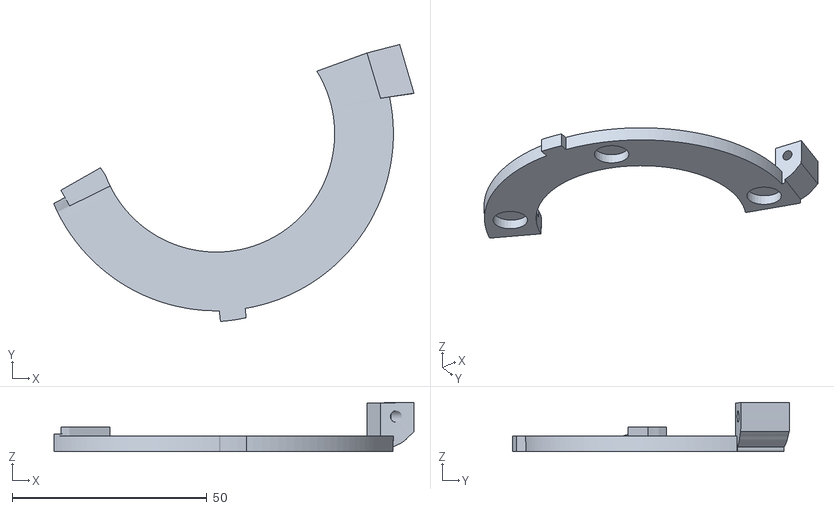
[picture p66: CAD file, 2026-09-29]
control_ui/twin/assets/components/EarLockV1-part1.stl
92.5 x 71.2 x 12.7
