uk-ux/inmoov-iris/control_ui/twin/assets/components/EarLockV1-part0.stl

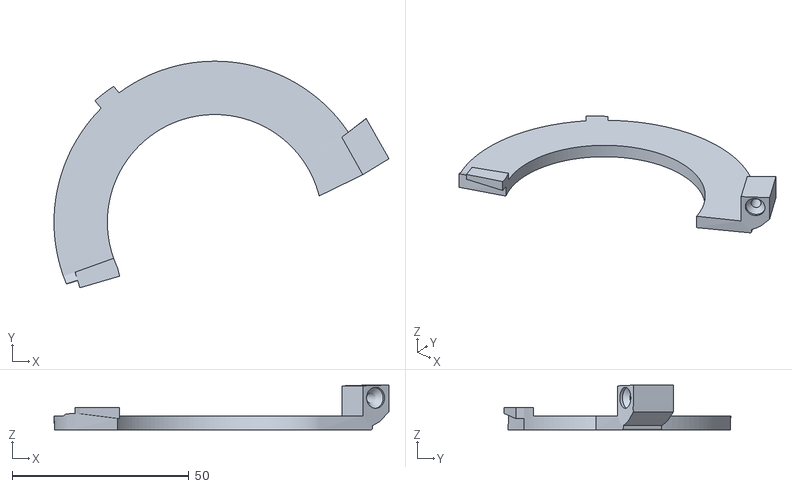
[picture p67: CAD file, 2026-09-29]
control_ui/twin/assets/components/EarLockV1-part0.stl
94.7 x 64.1 x 12.7
