uk-ux/inmoov-iris/(list of files, cad)

Other CAD files:
control_ui/twin/assets/components/Eye-L-AllPartsV2-part0.stl
control_ui/twin/assets/components/Eye-L-AllPartsV2-part8.stl
control_ui/twin/assets/components/ForHeadsV4-part1.stl
control_ui/twin/assets/components/Eye-R-AllPartsV2-part10.stl
control_ui/twin/assets/components/Eye-R-AllPartsV2-part8.stl
control_ui/twin/assets/components/Eye-L-AllPartsV2-part11.stl
control_ui/twin/assets/components/Eye-R-BaseV5-part0.stl
control_ui/twin/assets/components/EyebrowV3-part0.stl
control_ui/twin/assets/Eye-R-AllPartsV2.stl
control_ui/twin/assets/Eye-R-BaseV5.stl
control_ui/twin/assets/components/TopskullFrontV1-part0.stl
control_ui/twin/assets/components/Eye-R-AllPartsV2-part3.stl
control_ui/twin/assets/components/Eye-R-AllPartsV2-part15.stl
control_ui/twin/assets/components/Eye-L-AllPartsV2-part5.stl
control_ui/twin/assets/components/Eye-L-AllPartsV2-part3.stl
control_ui/twin/assets/components/Eye-R-AllPartsV2-part1.stl
control_ui/twin/assets/components/Eye-L-AllPartsV2-part9.stl
control_ui/twin/assets/components/JawSupportV2-part1.stl
control_ui/twin/assets/components/Eye-L-AllPartsV2-part4.stl
control_ui/twin/assets/components/Eye-R-AllPartsV2-part14.stl
control_ui/twin/assets/components/JawHingeV4-part0.stl
control_ui/twin/assets/components/Eye-R-AllPartsV2-part7.stl
control_ui/twin/assets/components/CheekPullerV3-part0.stl
control_ui/twin/assets/components/Eye-R-AllPartsV2-part6.stl
control_ui/twin/assets/components/Eye-L-AllPartsV2-part2.stl
control_ui/twin/assets/components/Eye-R-AllPartsV2-part12.stl
control_ui/twin/assets/components/TopskullFrontV1-part3.stl
control_ui/twin/assets/components/Eye-L-AllPartsV2-part13.stl
control_ui/twin/assets/components/Eye-L-AllPartsV2-part6.stl
