uk-ux/inmoov-iris/hardware/assembly-references/head_0.png

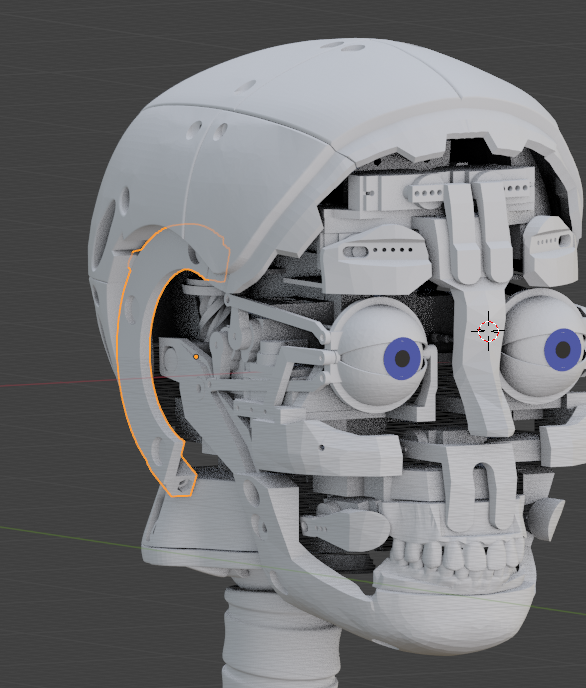
hardware/assembly-references/head_0.png
