uk-ux/inmoov-iris/hardware/assembly-references/head_0bis.png

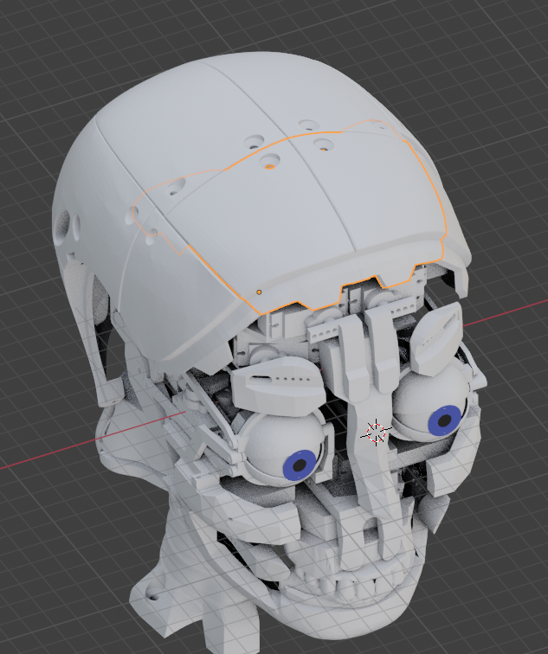
hardware/assembly-references/head_0bis.png
