uk-ux/inmoov-iris/hardware/assembly-references/head_1.png

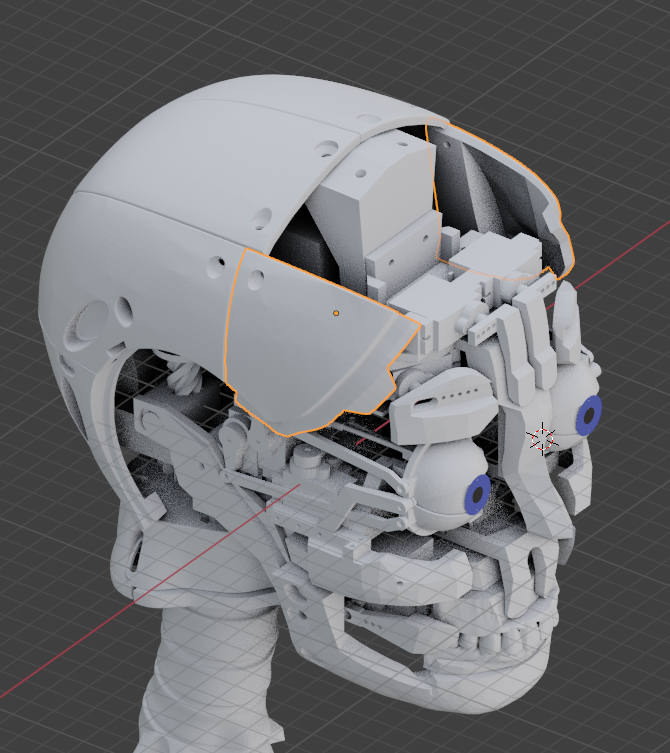
hardware/assembly-references/head_1.png
