uk-ux/inmoov-iris/hardware/assembly-references/head_2.png

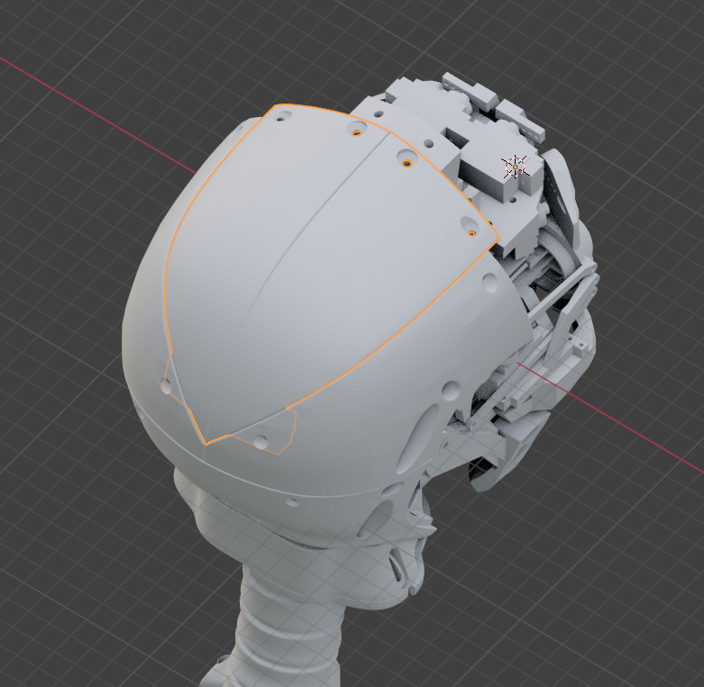
hardware/assembly-references/head_2.png
