uk-ux/inmoov-iris/hardware/assembly-references/head_3.png

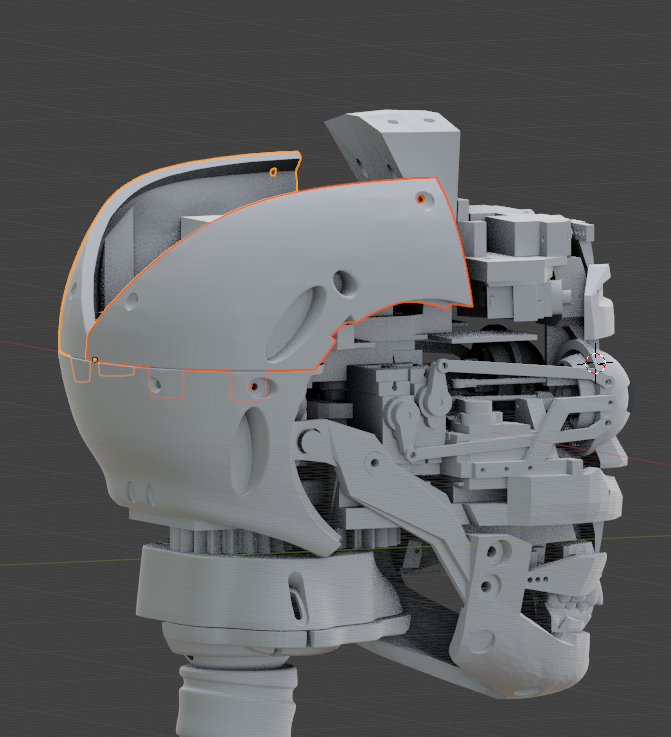
hardware/assembly-references/head_3.png
