uk-ux/inmoov-iris/hardware/assembly-references/head_4.png

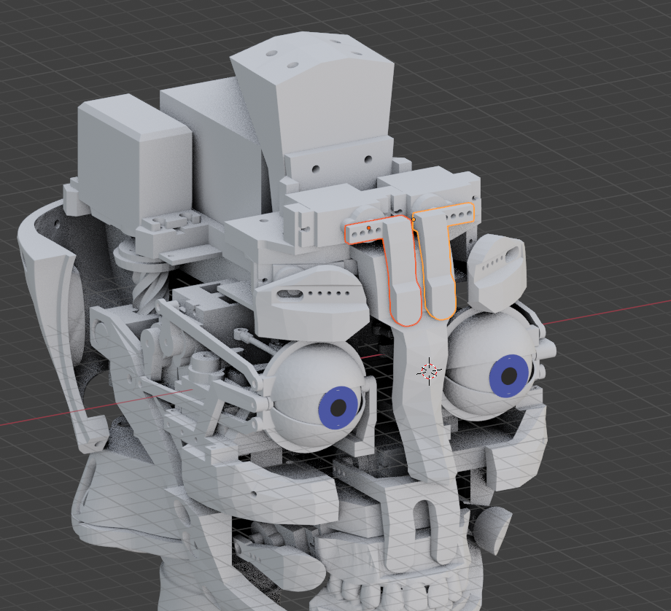
hardware/assembly-references/head_4.png
