uk-ux/inmoov-iris/hardware/assembly-references/head_5.png

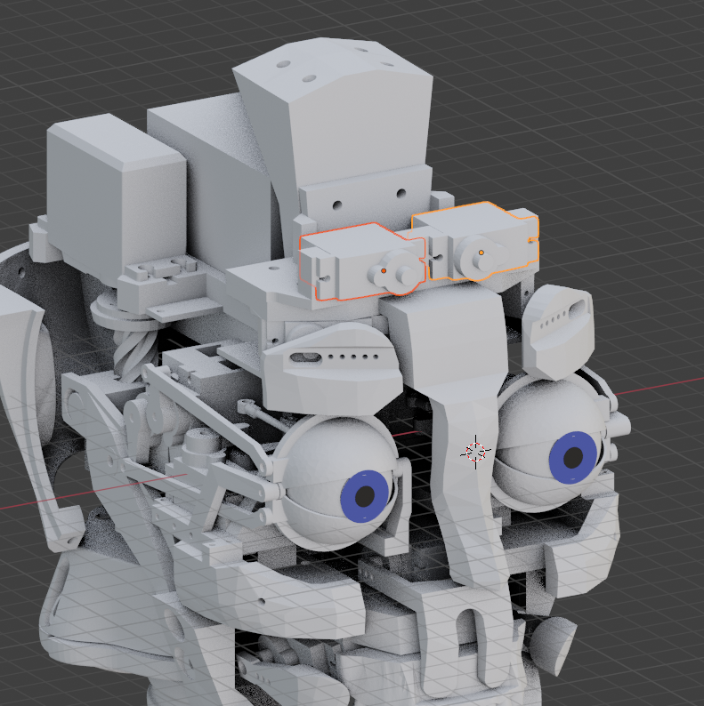
hardware/assembly-references/head_5.png
