uk-ux/inmoov-iris/hardware/assembly-references/head_6.png

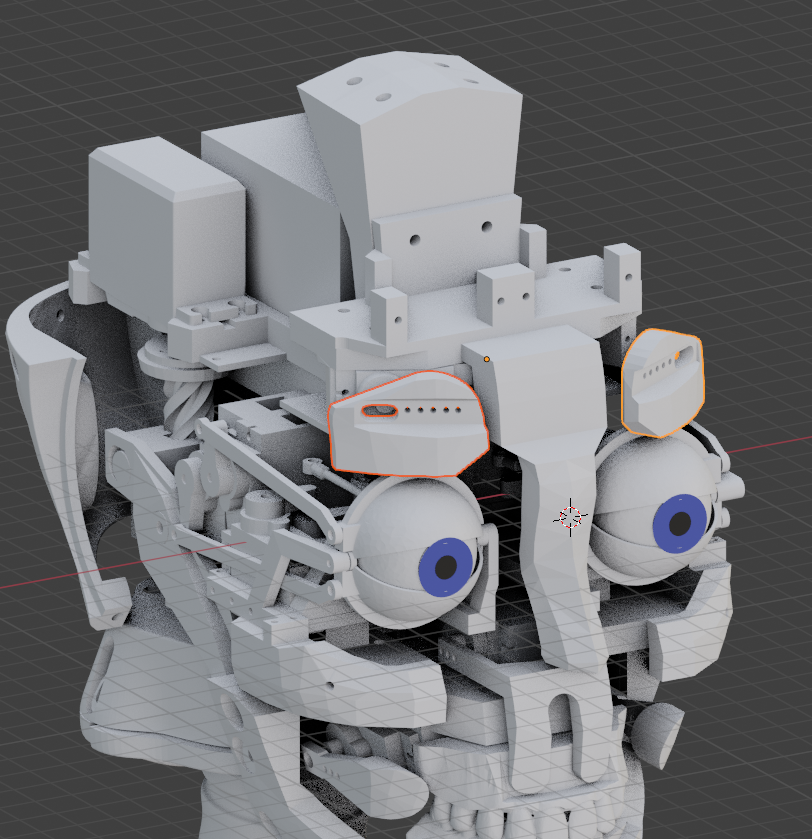
hardware/assembly-references/head_6.png
