uk-ux/inmoov-iris/hardware/assembly-references/head_7.png

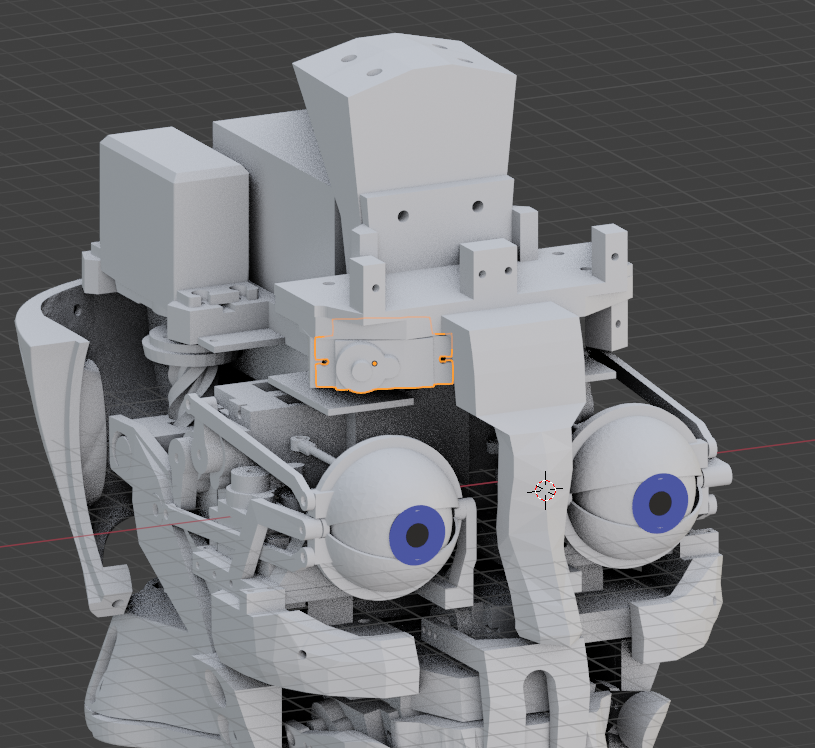
hardware/assembly-references/head_7.png
