uk-ux/inmoov-iris/hardware/assembly-references/head_8.png

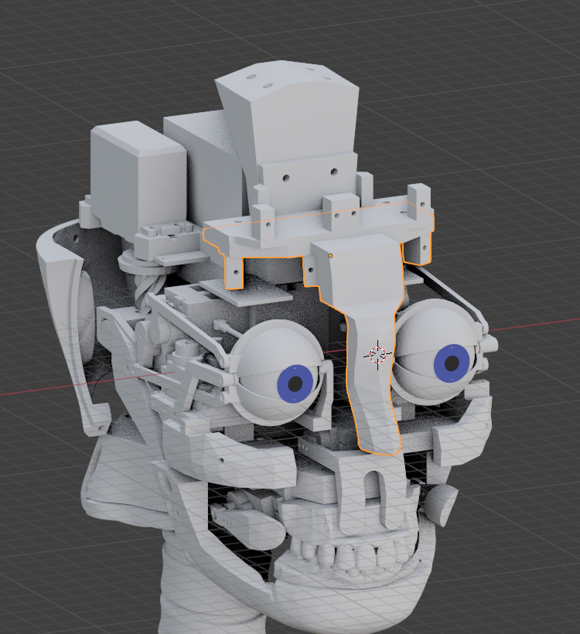
hardware/assembly-references/head_8.png
