uk-ux/inmoov-iris/hardware/assembly-references/head_10.png

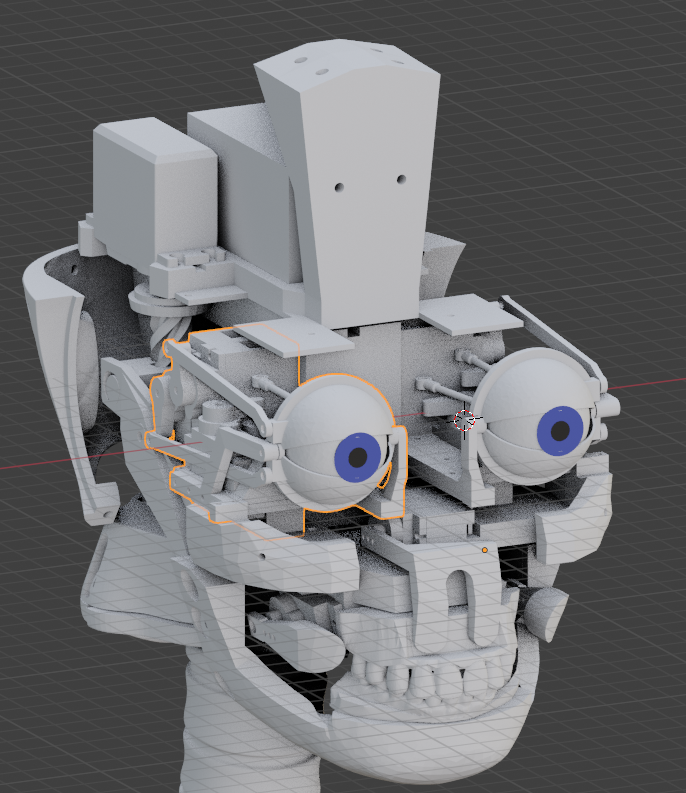
hardware/assembly-references/head_10.png
