uk-ux/inmoov-iris/hardware/assembly-references/head_12.png

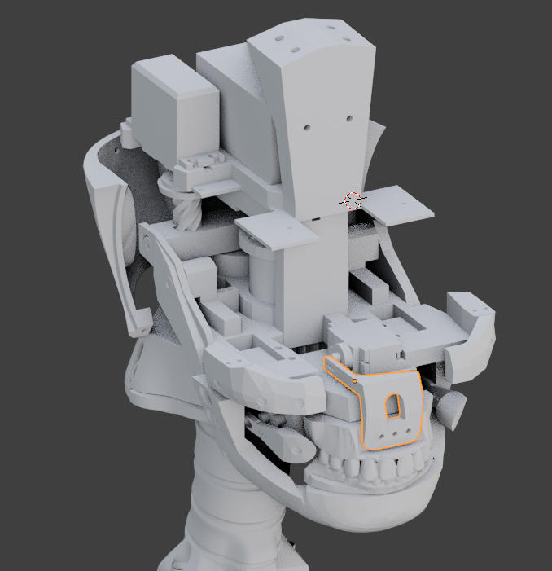
hardware/assembly-references/head_12.png
