uk-ux/inmoov-iris/hardware/assembly-references/head_13.png

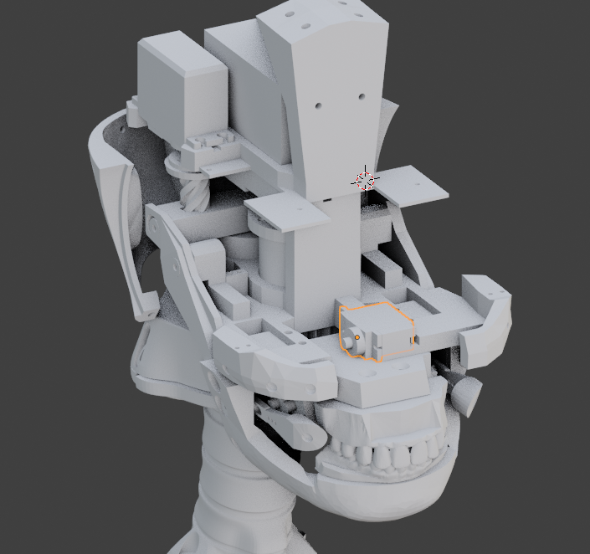
hardware/assembly-references/head_13.png
