uk-ux/inmoov-iris/hardware/assembly-references/head_14.png

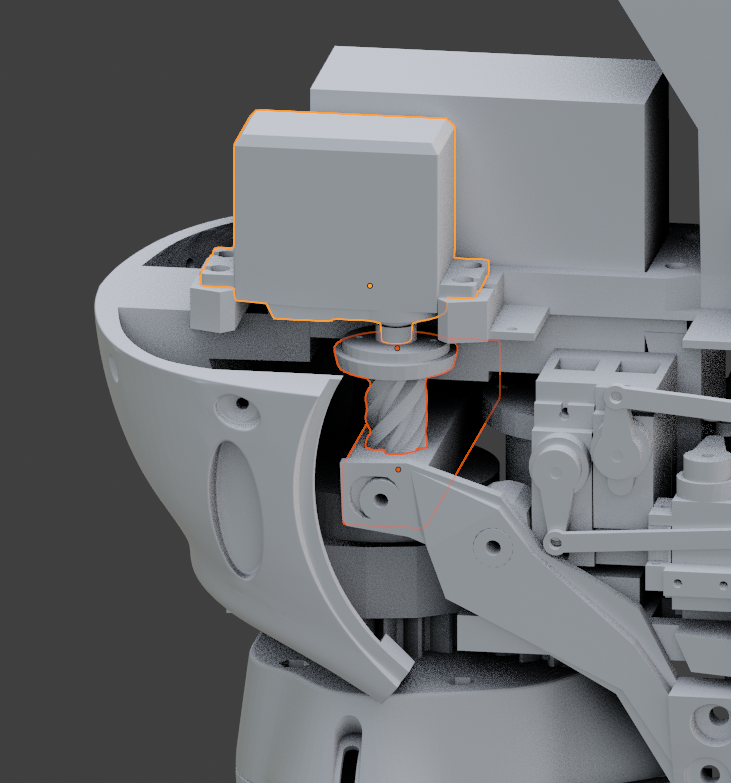
hardware/assembly-references/head_14.png
