uk-ux/inmoov-iris/hardware/assembly-references/head_15.png

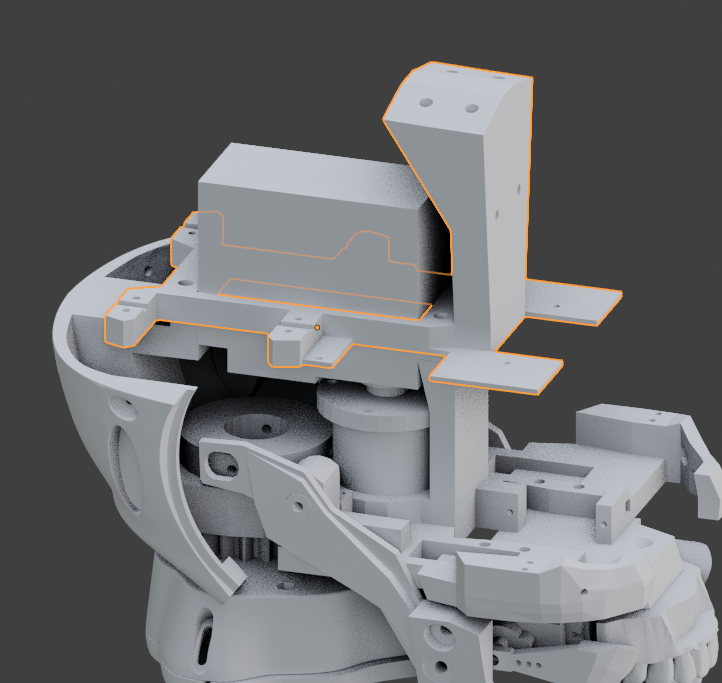
hardware/assembly-references/head_15.png
