uk-ux/inmoov-iris/hardware/assembly-references/head_16bis.png

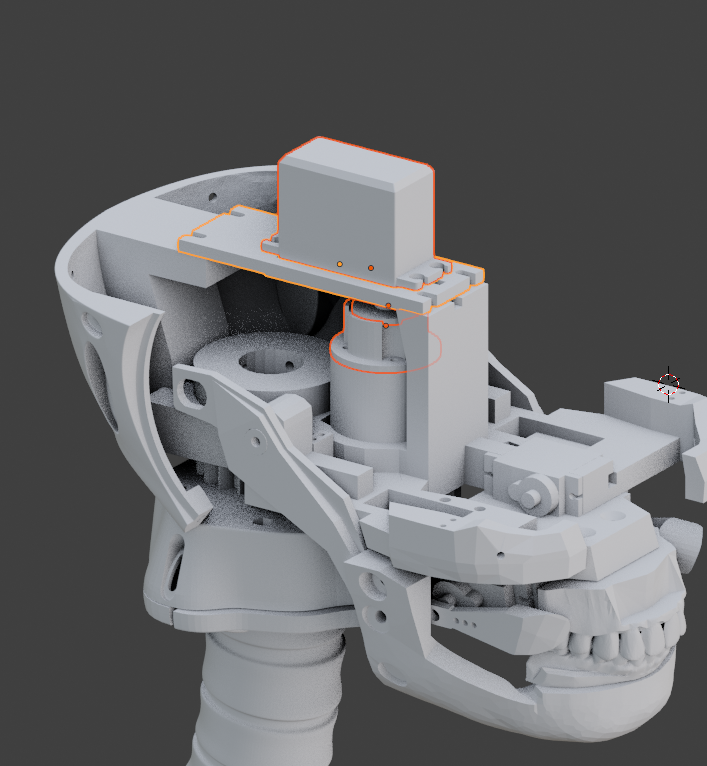
hardware/assembly-references/head_16bis.png
