uk-ux/inmoov-iris/hardware/assembly-references/head_17.png

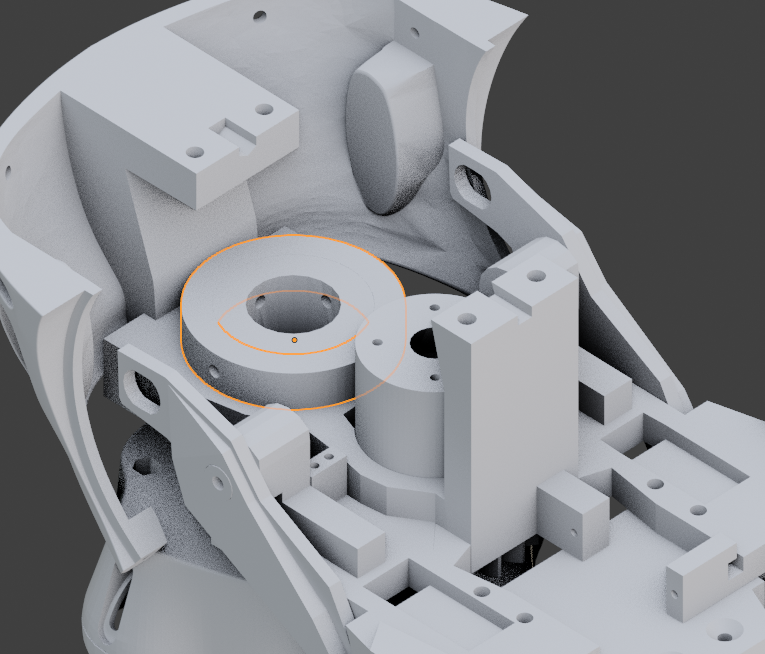
hardware/assembly-references/head_17.png
