uk-ux/inmoov-iris/hardware/assembly-references/head_18.png

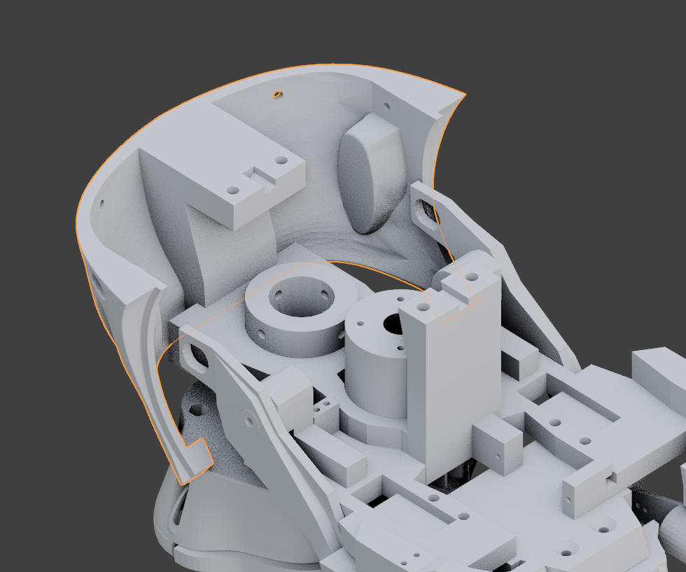
hardware/assembly-references/head_18.png
