uk-ux/inmoov-iris/hardware/assembly-references/head_19.png

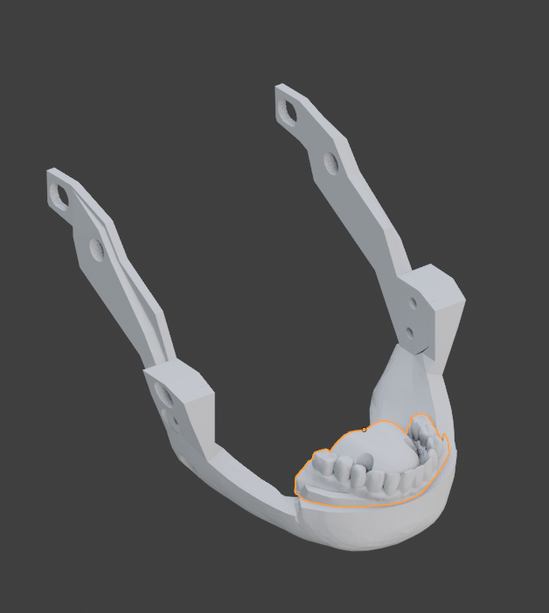
hardware/assembly-references/head_19.png
