uk-ux/inmoov-iris/hardware/assembly-references/head_20.png

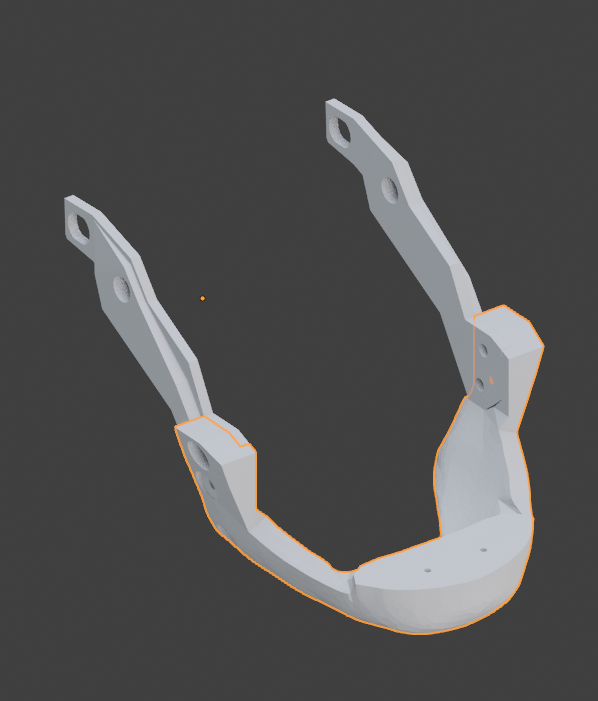
hardware/assembly-references/head_20.png
