uk-ux/inmoov-iris/hardware/assembly-references/head_21.png

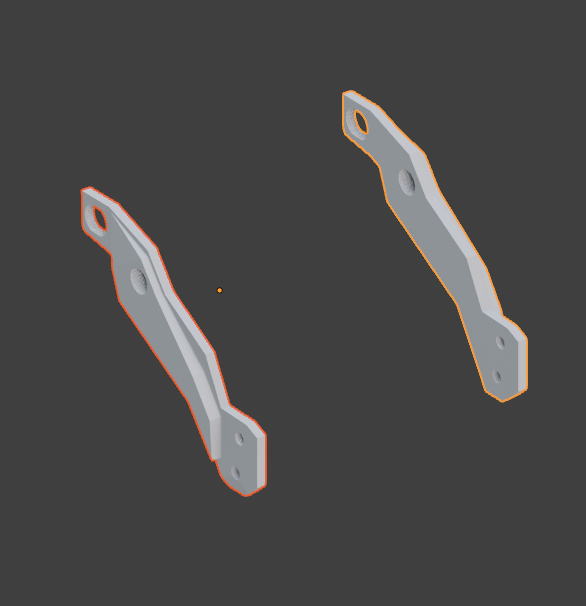
hardware/assembly-references/head_21.png
