uk-ux/inmoov-iris/hardware/assembly-references/head_22.png

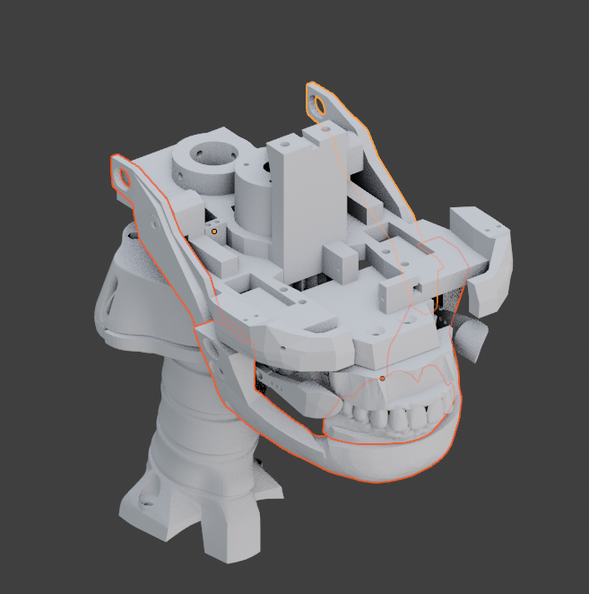
hardware/assembly-references/head_22.png
