uk-ux/inmoov-iris/hardware/assembly-references/head_24.png

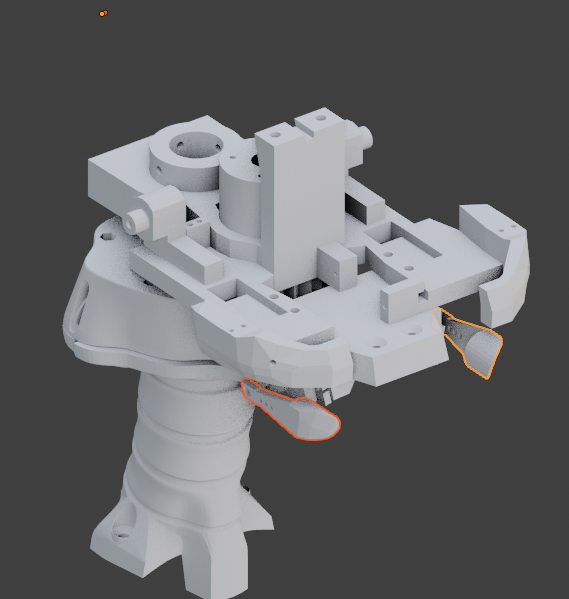
hardware/assembly-references/head_24.png
