uk-ux/inmoov-iris/hardware/assembly-references/head_25.png

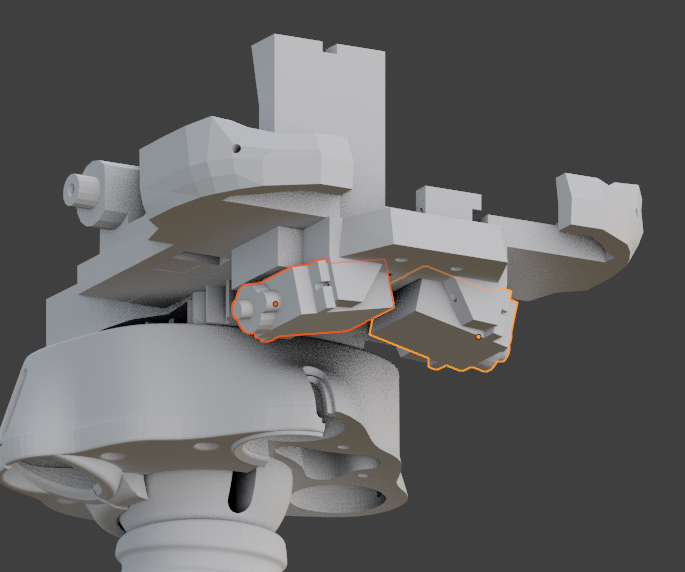
hardware/assembly-references/head_25.png
