uk-ux/inmoov-iris/hardware/assembly-references/head_26.png

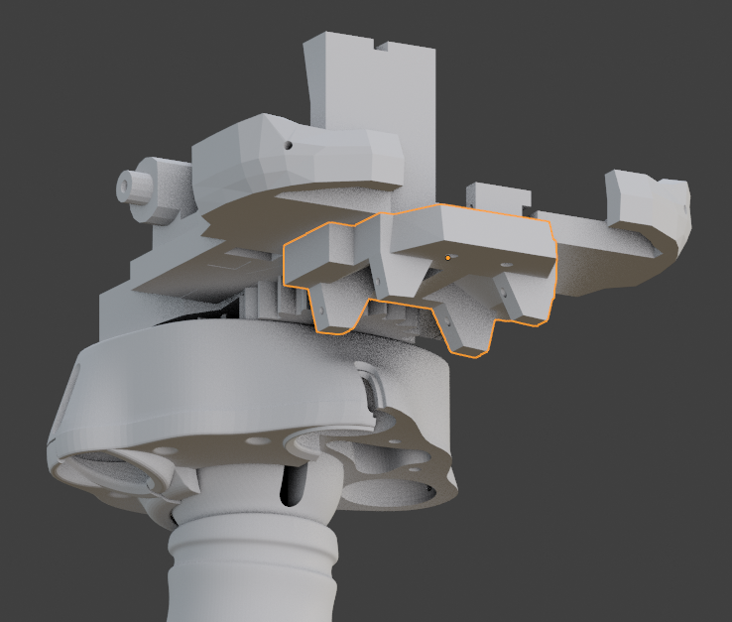
hardware/assembly-references/head_26.png
