uk-ux/inmoov-iris/hardware/assembly-references/head_27.png

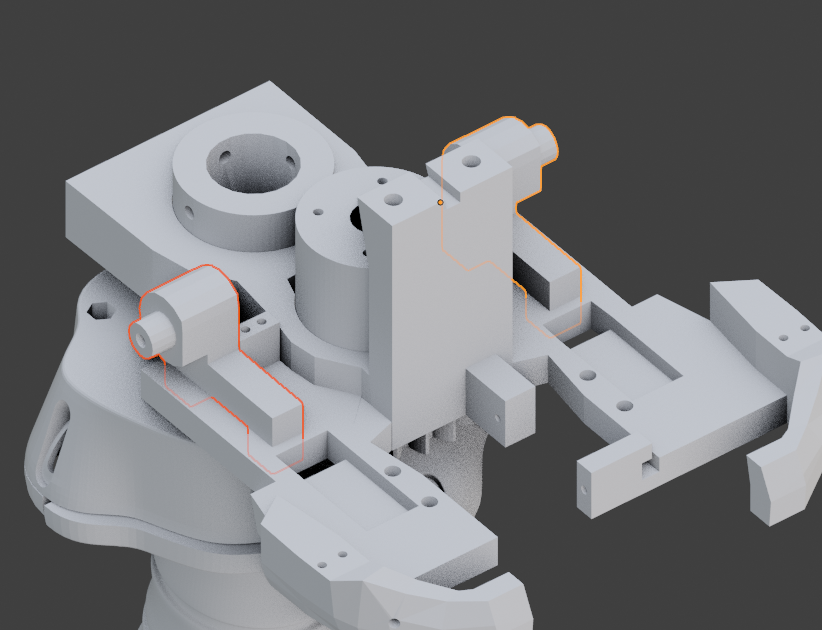
hardware/assembly-references/head_27.png
