uk-ux/inmoov-iris/hardware/assembly-references/head_28.png

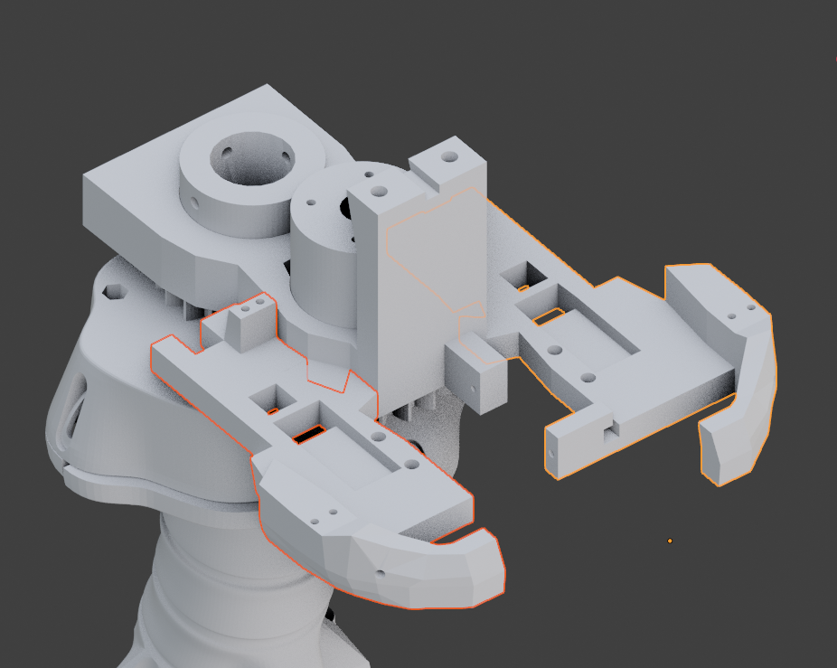
hardware/assembly-references/head_28.png
