uk-ux/inmoov-iris/hardware/assembly-references/head_29.png

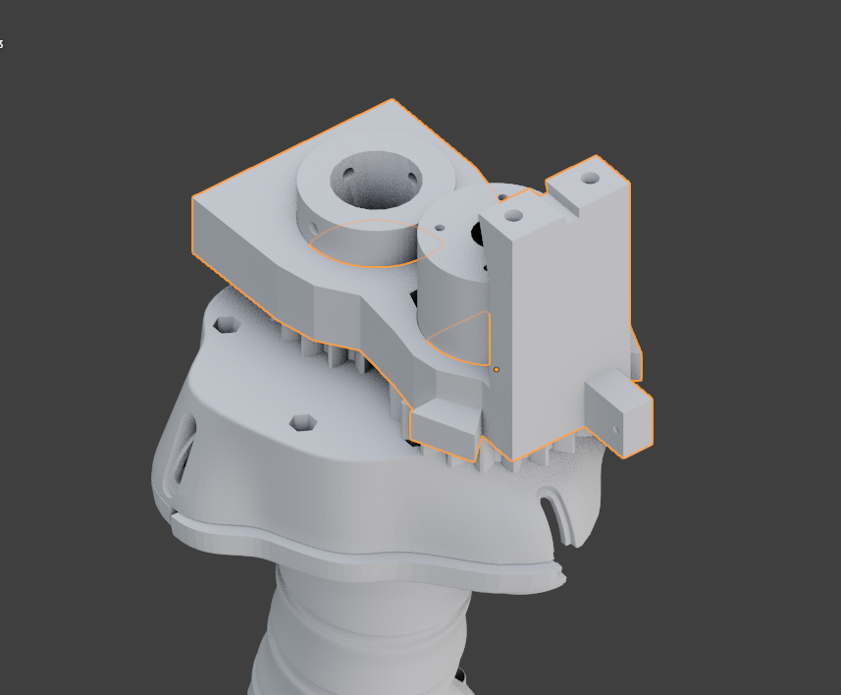
hardware/assembly-references/head_29.png
