uk-ux/inmoov-iris/hardware/assembly-references/head_31.png

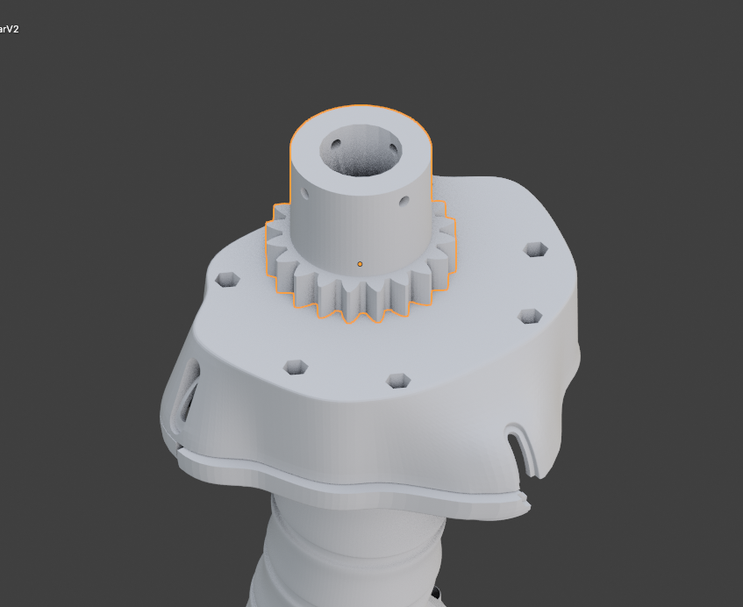
hardware/assembly-references/head_31.png
