uk-ux/inmoov-iris/control_ui/calibrator.html

INMOOV HEAD / UNO + PCA9685

# 16-servo calibration workspace

Calibrate one channel at a time. Values are saved in this browser and can be exported for firmware review.

Fast calibrator Back to face control Connect Uno

ConnectionDisconnected

Progress0 / 16 saved

SelectedCH0

ControllerOutputs off

## Before every movement

Keep the servo-power switch reachable. Check that the selected linkage is clear. A calibration position is a command scale, not a measured physical angle.

Mechanism clear; I can cut servo power Outputs off

CHANNELS

## Choose one servo

0 saved

EYES

## Left eye horizontal

Servo 1 / PCA channel 0

Not saved

Calibration position

deg

Pulse

us

Left0-180 calibration scaleRight

-10 us -5 us Move selected servo +5 us +10 us

Connect the Uno. Selecting a servo does not move it.

Left endpointNot recordedRecord current

Neutral / restNot recordedRecord current

Right endpointNot recordedRecord current

Save this calibration in page Save and select next Load current firmware baseline

Saving here uses browser storage. It does not change firmware limits or upload anything to the Uno.

SAVED RESULTS

## Calibration table

Export JSONExport CSV

CH | Part | Endpoint A | Neutral/rest | Endpoint B | Updated
