uk-ux/inmoov-iris/firmware/face_8_servo_uno/face_8_servo_uno.ino

#include <Wire.h>

// Uno A4=SDA, A5=SCL. PCA VCC from Uno 5V; servo V+ from external supply.
// Commands at 115200 baud: 1=animate, 2=neutral, 0=all outputs off.
// B1 closes all four eyelids together; B0 opens all four together.
// Uses exact saved pulse values for the calibrated mechanisms.
const uint8_t PCA = 0x40;
const uint8_t SERVO_COUNT = 16;
const uint8_t CH[SERVO_COUNT] = {0,1,2,3,4,5,6,7,8,9,12,13,10,11,14,15};
// Order: left-eye horizontal/vertical, right-eye horizontal/vertical,
// left/right eyebrow, left/right forehead.
const int NEUTRAL_US[SERVO_COUNT] = {1477,1500,1477,1522,1322,1588,1655,1322,1500,1500,1455,1566,1411,1300,1500,1500};
const int MINIMUM_US[SERVO_COUNT] = {1300,1300,1300,1300,1322,1411,1500,1322,1322,1322,1344,1322,1366,1300,1300,1300};
const int MAXIMUM_US[SERVO_COUNT] = {1700,1700,1700,1700,1500,1588,1655,1500,1677,1700,1700,1611,1500,1700,1700,1700};
const int LID_CLOSED_US[4] = {1500,1411,1500,1500};
bool autoBlink=false, lidsOverride=false, lidsClosed=false;
int current[SERVO_COUNT], fromPose[SERVO_COUNT], target[SERVO_COUNT];
int lidFrom[4], lidCurrent[4], lidTarget[4];
unsigned long lidStarted[2]={0,0}, nextBlink=0;
uint8_t lidMask=0;
void setEyes(uint8_t mask){
  for(uint8_t eye=0;eye<2;eye++){
    if(lidsOverride&&((mask^lidMask)&(1<<eye))==0)continue;
    for(uint8_t j=eye*2;j<eye*2+2;j++){
      lidFrom[j]=lidsOverride?lidCurrent[j]:current[j+4];
      lidCurrent[j]=lidFrom[j];lidTarget[j]=(mask&(1<<eye))?LID_CLOSED_US[j]:NEUTRAL_US[j+4];
    }
    lidStarted[eye]=millis();
  }
  lidMask=mask;lidsClosed=mask==3;lidsOverride=true;
}
void blink(bool closeLids){setEyes(closeLids?3:0);}
uint16_t previousTicks[SERVO_COUNT] = {0};
bool ready=false, enabled=false, running=false, moving=false, returning=false;
unsigned long started=0, travel=700, hold=1200, nextMove=0, frame=0;
char commandLine[20];
uint8_t commandLength=0;
bool discardCommand=false;
unsigned long lastCommandByte=0;

bool writeReg(uint8_t reg, uint8_t value) {
  Wire.beginTransmission(PCA); Wire.write(reg); Wire.write(value);
  return Wire.endTransmission()==0;
}
bool pwm(uint8_t ch, uint16_t ticks) {
  Wire.beginTransmission(PCA); Wire.write(0x06+4*ch);
  Wire.write((uint8_t)0); Wire.write((uint8_t)0);
  Wire.write((uint8_t)(ticks&255)); Wire.write((uint8_t)(ticks>>8));
  return Wire.endTransmission()==0;
}
bool off() {
  enabled=false; running=false; moving=false;
  autoBlink=false;lidsOverride=false;
  bool ok=true; for(uint8_t i=0;i<16;++i) if(!pwm(i,4096)) ok=false;
  for(uint8_t i=0;i<SERVO_COUNT;++i) previousTicks[i]=0;
  return ok;
}
void fault() { ready=false; off(); Serial.println(F("I2C FAULT: cut servo power and check wiring.")); }
bool sendPose() {
  if(lidsOverride){
    for(uint8_t j=0;j<4;j++){
      float t=min(1.0f,(float)(millis()-lidStarted[j/2])/80.0f);
      float e=t*t*(3-2*t);
      lidCurrent[j]=lidFrom[j]+(int)((lidTarget[j]-lidFrom[j])*e);current[j+4]=lidCurrent[j];
    }
  }
  for(uint8_t i=0;i<SERVO_COUNT;++i) {
    current[i]=constrain(current[i],MINIMUM_US[i],MAXIMUM_US[i]);
    uint16_t ticks=((long)current[i]*4096+10000)/20000;
    if(ticks!=previousTicks[i]) { if(!pwm(CH[i],ticks)){fault();return false;} previousTicks[i]=ticks; }
  }
  return true;
}
void moveTo(const int pose[SERVO_COUNT], unsigned long ms, unsigned long pause) {
  for(uint8_t i=0;i<SERVO_COUNT;++i){fromPose[i]=current[i];target[i]=pose[i];}
  started=millis(); travel=ms; hold=pause; moving=true;
}
void neutralMove() { moveTo(NEUTRAL_US,500,1800); returning=true; }
void expression() {
  // Last three entries: jaw CH11, left cheek CH14, right cheek CH15.
  // Cheek lift uses decreasing left pulses and increasing right pulses.
  // Each expression returns to closed jaw / relaxed cheeks through neutralMove.
  const int poses[5][SERVO_COUNT] = {
    {1422,1500,1422,1522,1322,1588,1655,1322,1322,1700,1700,1322,1411,1420,1360,1640}, // attentive smile
    {1555,1495,1555,1527,1322,1588,1655,1322,1322,1322,1700,1611,1411,1480,1400,1680}, // smiling glance right
    {1400,1504,1400,1518,1322,1588,1655,1322,1677,1700,1344,1322,1411,1380,1640,1360}, // concerned glance left
    {1477,1433,1477,1589,1322,1588,1655,1322,1322,1700,1700,1322,1460,1620,1420,1580}, // open-mouth surprise
    {1511,1544,1444,1478,1411,1500,1655,1322,1677,1700,1344,1322,1388,1360,1360,1440}  // asymmetric skeptical expression
  };
  moveTo(poses[random(0,5)],random(450,701),random(700,1801));
  returning=true;
}
void command() {
  if(discardCommand||commandLength==0)return;
  if(commandLength==1&&commandLine[0]=='0'){if(!off())fault();else Serial.println(F("OFF"));return;}
  // Auto blink runs on the Uno, independent of browser timer throttling.
  // E0 both open; E1 left wink; E2 right wink; E3 both closed.
  if(commandLength==2&&commandLine[0]=='E'&&commandLine[1]>='0'&&commandLine[1]<='3'){
    if(!ready)return;
    if(!enabled){for(uint8_t i=0;i<SERVO_COUNT;i++)current[i]=NEUTRAL_US[i];if(!sendPose())return;enabled=true;}
    autoBlink=false;setEyes(commandLine[1]-'0');return;
  }
  if(commandLength==2&&commandLine[0]=='A'&&(commandLine[1]=='0'||commandLine[1]=='1')){
    if(!ready)return;
    if(!enabled){for(uint8_t i=0;i<SERVO_COUNT;i++)current[i]=NEUTRAL_US[i];if(!sendPose())return;enabled=true;}
    autoBlink=commandLine[1]=='1';blink(false);nextBlink=millis()+random(2500,5501);
    Serial.println(autoBlink?F("AUTO BLINK ON"):F("AUTO BLINK OFF"));return;
  }
  if(commandLength==2&&(commandLine[0]=='B'||commandLine[0]=='b')&&
     (commandLine[1]=='0'||commandLine[1]=='1')) {
    if(!ready)return;
    if(!enabled){for(uint8_t i=0;i<SERVO_COUNT;++i)current[i]=NEUTRAL_US[i];if(!sendPose())return;enabled=true;}
    const bool closeLids=commandLine[1]=='1';
    autoBlink=false;blink(closeLids);
    Serial.println(closeLids?F("BLINK CLOSED"):F("BLINK OPEN"));
    return;
  }
  if(commandLength>=6&&(commandLine[0]=='C'||commandLine[0]=='c'||commandLine[0]=='K')) {
    if(!ready)return;
    uint8_t p=1; int requestedChannel=0; bool channelDigit=false;
    while(p<commandLength&&commandLine[p]>='0'&&commandLine[p]<='9'){
      channelDigit=true;requestedChannel=requestedChannel*10+commandLine[p++]-'0';
    }
    if(!channelDigit||p>=commandLength||commandLine[p++]!=' ')return;
    int servo=-1;for(uint8_t i=0;i<SERVO_COUNT;++i)if(CH[i]==requestedChannel)servo=i;
    if(servo<0){Serial.println(F("REJECTED: channel not controlled"));return;}
    int pulse=0; bool digit=false;
    while(p<commandLength&&commandLine[p]>='0'&&commandLine[p]<='9'){
      digit=true;pulse=pulse*10+commandLine[p++]-'0';if(pulse>2000)return;
    }
    while(p<commandLength&&commandLine[p]==' ')++p;
    if(!digit||p!=commandLength||pulse<MINIMUM_US[servo]||pulse>MAXIMUM_US[servo]){
      Serial.println(F("REJECTED: pulse outside calibrated range"));return;
    }
    if(commandLine[0]=='K'){
      // Isolated calibration pulse, with automatic motions and other outputs off.
      if(!off()){fault();return;}
      current[servo]=pulse;
      if(!pwm(CH[servo],((long)pulse*4096+10000)/20000)){fault();return;}
      Serial.print(F("CAL CH"));Serial.print(requestedChannel);Serial.print(F(" PULSE "));Serial.println(pulse);
      return;
    }
    if(!enabled){for(uint8_t i=0;i<SERVO_COUNT;++i)current[i]=NEUTRAL_US[i];if(!sendPose())return;enabled=true;}
    running=false;
    int manualPose[SERVO_COUNT];
    // If UI commands arrive together, retain targets already queued for the
    // other servos so the final command represents the complete face pose.
    for(uint8_t i=0;i<SERVO_COUNT;++i)manualPose[i]=moving?target[i]:current[i];
    manualPose[servo]=pulse;
    if(servo>=4&&servo<=7){autoBlink=false;lidsOverride=false;}
    // Eyelids imitate short camera frames; the other features use a little more
    // smoothing. Eyelid commands arrive last in each camera pose update.
    moveTo(manualPose,(requestedChannel>=4&&requestedChannel<=7)?130:90,0);
    Serial.print(F("CHANNEL "));Serial.print(requestedChannel);Serial.print(F(" PULSE "));Serial.println(pulse);
    return;
  }
  if(commandLength!=1||(commandLine[0]!='1'&&commandLine[0]!='2'))return;
  char input=commandLine[0];
  if(!ready)return;
  if(!enabled){for(uint8_t i=0;i<SERVO_COUNT;++i)current[i]=NEUTRAL_US[i];if(!sendPose())return;enabled=true;}
  if(input=='2'){autoBlink=false;lidsOverride=false;running=false;neutralMove();Serial.println(F("NEUTRAL"));}
  else {running=true;neutralMove();Serial.println(F("RUNNING"));}
}
void setup() {
  Serial.begin(115200); Wire.begin(); Wire.setClock(100000); Wire.setWireTimeout(25000,true);
  if(!off()||!writeReg(0x00,0x10)||!writeReg(0xFE,121)||!writeReg(0x00,0x20)){fault();return;}
  delay(5); if(!writeReg(0x00,0xA0)||!off()){fault();return;}
  randomSeed(analogRead(A0)); for(uint8_t i=0;i<SERVO_COUNT;++i)current[i]=NEUTRAL_US[i];
  ready=true; Serial.println(F("READY calibrated 16-servo face - outputs OFF"));
}
void loop() {
  while(Serial.available()) {
    char c=Serial.read();lastCommandByte=millis();
    if(c=='\r'||c=='\n'){
      if(commandLength||discardCommand)command();
      commandLength=0;discardCommand=false;
    }else if(!discardCommand){
      if(commandLength<sizeof(commandLine))commandLine[commandLength++]=c;
      else discardCommand=true;
    }
  }
  if((commandLength||discardCommand)&&millis()-lastCommandByte>=40){
    command();commandLength=0;discardCommand=false;
  }
  if(!ready||!enabled)return;
  unsigned long now=millis();if(now-frame<20)return;frame=now;
  if(autoBlink){
    if(lidsClosed&&now-lidStarted[0]>=180){blink(false);nextBlink=now+random(2500,5501);}
    else if(!lidsClosed&&(long)(now-nextBlink)>=0)blink(true);
  }
  if(moving){unsigned long elapsed=now-started;
    float t=min(1.0f,(float)elapsed/travel);float e=t*t*t*(10.0f+t*(-15.0f+6.0f*t));
    for(uint8_t i=0;i<SERVO_COUNT;++i)current[i]=fromPose[i]+(int)((target[i]-fromPose[i])*e);
    if(!sendPose())return;
    if(elapsed>=travel){moving=false;nextMove=now+hold;}
  } else if(running&&(long)(now-nextMove)>=0){
    if(returning){expression();returning=false;}
    else{neutralMove();returning=true;}
  }
  if(lidsOverride&&!sendPose())return;
}
