uk-ux/inmoov-iris/voice/skills.py

"""InMoov skills — turning speech into actions.

Two layers, fast first:

  1. FAST INTENTS (this file) — regex patterns in English and Tamil that map
     straight to an action. Zero model latency: "look around" fires in about
     a millisecond instead of waiting 5 s for an 8B model to emit a tool call.
     This is why commands feel instant while conversation still feels smart.

  2. The LLM handles everything that is not a command.

Robot motion goes out over the same serial protocol the browser UI uses
(C<ch> <pulse>), so nothing new had to be added to the firmware.
Laptop control is a fixed allow-list — never arbitrary shell execution.
"""
import os, re, subprocess, time, threading
from pathlib import Path

# ---------------------------------------------------------------- robot link
class Robot:
    """Serial link to the Uno. Safe by default: does nothing unless enabled."""

    def __init__(self, port=None, baud=115200):
        self.port, self.baud, self.ser = port, baud, None
        self.lock = threading.Lock()
        self.last_error = None

    def connect(self):
        if not self.port or self.ser:
            return self.ser is not None
        try:
            import serial
            self.ser = serial.Serial(self.port, self.baud, timeout=1)
            time.sleep(2.0)          # Uno resets on open; firmware prints READY
            self.ser.reset_input_buffer()
            return True
        except Exception as e:
            self.last_error = str(e)[:120]
            self.ser = None
            return False

    def send(self, line):
        if not self.ser and not self.connect():
            return False
        try:
            with self.lock:
                self.ser.write((line + "\n").encode())
            return True
        except Exception as e:
            self.last_error = str(e)[:120]
            self.ser = None
            return False

    def pose(self, moves, hold=0.0):
        """moves: {channel: pulse}. Sends one channel at a time, like the UI."""
        ok = all(self.send(f"C{ch} {us}") for ch, us in moves.items())
        if hold:
            time.sleep(hold)
        return ok

    def off(self):
        return self.send("0")

    @property
    def available(self):
        return bool(self.port)


robot = Robot()      # server sets robot.port when the user enables motion

# Calibrated rest values from INMOOV_AGENT_HANDOFF.md. Every pose below stays
# inside the compiled firmware limits, and the firmware rejects anything that
# does not — so a bad value here cannot drive a servo past its stop.
REST = {0: 1477, 1: 1500, 2: 1477, 3: 1522, 8: 1500, 9: 1500,
        10: 1411, 11: 1300, 12: 1455, 13: 1566, 14: 1500, 15: 1500}
EYES_L = {0: 1360, 2: 1360}
EYES_R = {0: 1600, 2: 1600}
EYES_C = {0: 1477, 2: 1477}
EYES_UP = {1: 1400, 3: 1620}
EYES_DOWN = {1: 1600, 3: 1420}
SMILE = {8: 1400, 9: 1600, 14: 1380, 15: 1620, 11: 1340}
SAD = {8: 1620, 9: 1380, 14: 1600, 15: 1400}
SURPRISE = {1: 1433, 3: 1589, 8: 1322, 9: 1700, 11: 1560, 12: 1700, 13: 1322}


def _look_around():
    """A slow scan: right, left, centre. Reads as curiosity, not a twitch."""
    robot.pose(EYES_R, 0.75)
    robot.pose(EYES_L, 0.95)
    robot.pose(EYES_C, 0.4)
    return "Looking around."


def _blink(times=2):
    for _ in range(times):
        robot.send("B1"); time.sleep(0.16)
        robot.send("B0"); time.sleep(0.28)
    return "Blinking."


def _expression(pose, name):
    robot.pose(pose, 1.6)
    robot.pose(REST)
    return name


# ---------------------------------------------------------------- laptop link
def _run(args):
    try:
        subprocess.Popen(args, shell=False,
                         creationflags=getattr(subprocess, "CREATE_NO_WINDOW", 0))
        return True
    except Exception:
        return False


def _ps(script):
    return _run(["powershell", "-NoProfile", "-WindowStyle", "Hidden",
                 "-Command", script])


def _volume(direction, steps=5):
    key = {"up": 175, "down": 174, "mute": 173}[direction]
    _ps("$w=New-Object -ComObject WScript.Shell;" +
        f"1..{steps}|%{{$w.SendKeys([char]{key})}}")
    return {"up": "Volume up.", "down": "Volume down.", "mute": "Muted."}[direction]


def _media(key, msg):
    """One media key press: 179 play/pause, 176 next, 177 previous."""
    _ps(f"$w=New-Object -ComObject WScript.Shell;$w.SendKeys([char]{key})")
    return msg


def _brightness(delta):
    _ps("$b=(Get-WmiObject -Namespace root/WMI -Class WmiMonitorBrightness).CurrentBrightness;"
        f"$n=[Math]::Max(0,[Math]::Min(100,$b+({delta})));"
        "(Get-WmiObject -Namespace root/WMI -Class WmiMonitorBrightnessMethods).WmiSetBrightness(1,$n)")
    return "Brightness up." if delta > 0 else "Brightness down."


APPS = {
    "notepad": "notepad.exe", "calculator": "calc.exe", "calculator app": "calc.exe",
    "chrome": "chrome.exe", "browser": "chrome.exe", "edge": "msedge.exe",
    "explorer": "explorer.exe", "file explorer": "explorer.exe",
    "files": "explorer.exe", "paint": "mspaint.exe", "terminal": "wt.exe",
    "camera": "microsoft.windows.camera:", "settings": "ms-settings:",
    "task manager": "taskmgr.exe", "calendar": "outlookcal:",
}

SITES = {
    "youtube": "https://www.youtube.com", "google": "https://www.google.com",
    "gmail": "https://mail.google.com", "email": "https://mail.google.com",
    "github": "https://github.com", "wikipedia": "https://www.wikipedia.org",
    "maps": "https://www.google.com/maps", "google maps": "https://www.google.com/maps",
    "whatsapp": "https://web.whatsapp.com", "instagram": "https://www.instagram.com",
    "spotify": "https://open.spotify.com",
    "news": "https://news.google.com", "the news": "https://news.google.com",
}

# Apps IRIS may force-close by name. Never explorer or the task manager —
# killing those takes the desktop down with them.
CLOSABLE = {
    "notepad": "notepad.exe", "calculator": "CalculatorApp.exe",
    "chrome": "chrome.exe", "browser": "chrome.exe", "edge": "msedge.exe",
    "paint": "mspaint.exe", "camera": "WindowsCamera.exe",
}


def _open_app(name):
    name = name.lower().strip(" .?!")
    url = SITES.get(name)
    if not url:
        for k, v in SITES.items():
            if k in name:
                url, name = v, k
                break
    if url:
        _run(["cmd", "/c", "start", "", url])
        return f"Opening {name}."
    exe = APPS.get(name)
    if not exe:
        for k, v in APPS.items():
            if k in name or name in k:
                exe, name = v, k
                break
    if not exe:
        return f"I do not know how to open {name}."
    _run(["cmd", "/c", "start", "", exe])
    return f"Opening {name}."


def _close_app(name):
    name = name.lower().strip(" .?!")
    exe = CLOSABLE.get(name)
    if not exe:
        for k, v in CLOSABLE.items():
            if k in name:
                exe, name = v, k
                break
    if not exe:
        return f"I can only close apps from my own list, and {name} is not on it."
    _run(["taskkill", "/IM", exe, "/F"])
    return f"Closing {name}."


def _web(url, msg):
    _run(["cmd", "/c", "start", "", url])
    return msg


def _search_web(q):
    from urllib.parse import quote_plus
    q = q.strip(" .?!")
    return _web("https://www.google.com/search?q=" + quote_plus(q), f"Searching for {q}.")


def _youtube(q):
    from urllib.parse import quote_plus
    q = q.strip(" .?!")
    return _web("https://www.youtube.com/results?search_query=" + quote_plus(q),
                f"Looking for {q} on YouTube.")


def _type_text(text):
    # SendKeys treats +^%~(){}[] as commands — wrap them, then double the
    # quotes so the text survives the PowerShell single-quoted string.
    esc = "".join("{%s}" % c if c in "+^%~(){}[]" else c for c in text)
    esc = esc.replace("'", "''")
    _ps("Add-Type -AssemblyName System.Windows.Forms;"
        f"[System.Windows.Forms.SendKeys]::SendWait('{esc}')")
    return "Typing."


def _minimize_all():
    _ps("(New-Object -ComObject Shell.Application).MinimizeAll()")
    return "Minimizing everything."


def _close_window():
    _ps("Add-Type -AssemblyName System.Windows.Forms;"
        "[System.Windows.Forms.SendKeys]::SendWait('%{F4}')")
    return "Closing the window."


def _sleep_pc():
    _run(["rundll32.exe", "powrprof.dll,SetSuspendState", "0,1,0"])
    return "Going to sleep. Wake me when you need me."


def _power(mode):
    """Shutdown and restart get a 30 s grace period and a spoken way out,
    so one misheard word can never pull the plug instantly."""
    if mode == "cancel":
        _run(["shutdown", "/a"])
        return "Cancelled. Staying on."
    _run(["shutdown", "/s" if mode == "off" else "/r", "/t", "30"])
    verb = "Shutting down" if mode == "off" else "Restarting"
    return f"{verb} in thirty seconds. Say cancel shutdown if you change your mind."


def _disk_space():
    import shutil
    parts = []
    for d in ("C:\\", "U:\\"):
        try:
            u = shutil.disk_usage(d)
            parts.append(f"{d[0]} drive has {u.free / 1e9:.0f} gigabytes free of {u.total / 1e9:.0f}")
        except Exception:
            pass
    return ("; ".join(parts) + ".") if parts else "I could not read the disks."


def _my_ip():
    import socket
    try:
        s = socket.socket(socket.AF_INET, socket.SOCK_DGRAM)
        s.connect(("8.8.8.8", 80))
        ip = s.getsockname()[0]
        s.close()
        return f"My local IP address is {ip}."
    except Exception:
        return "I could not read the network address."


def _screenshot():
    try:
        from PIL import ImageGrab
        out = Path.home() / "Pictures" / f"inmoov-{time.strftime('%H%M%S')}.png"
        out.parent.mkdir(exist_ok=True)
        ImageGrab.grab().save(out)
        return "Screenshot saved to your Pictures folder."
    except Exception:
        _ps("Add-Type -AssemblyName System.Windows.Forms;"
            "[System.Windows.Forms.SendKeys]::SendWait('{PRTSC}')")
        return "Screenshot copied to the clipboard."


def _diagnose():
    """A spoken health check of InMoov — the JARVIS 'run diagnostics' moment.

    Checks the serial link, asks the firmware for a safe state, and reports.
    It never drives a servo; it only confirms the head is reachable and safe.
    """
    if not robot.available:
        return ("Diagnostics: my body is not connected. Enable motion first, "
                "and make sure the calibrator is closed so I can use the port.")
    checks = []
    # 1. serial link up?
    if robot.connect():
        checks.append("serial link to the controller is up")
    else:
        return f"Diagnostics failed: I cannot reach the controller. {robot.last_error or ''}"
    # 2. can the firmware accept a safe command?
    if robot.off():
        checks.append("all servo outputs are safely off")
    else:
        checks.append("WARNING: the controller did not confirm outputs off")
    # 3. report the known configuration
    checks.append("sixteen facial channels are configured")
    return "Diagnostics complete. " + ". ".join(c[0].upper() + c[1:] for c in checks) + "."


def _status_report():
    parts = []
    parts.append("my body is connected" if robot.available else "my body is not connected")
    try:
        parts.append(_battery().lower().rstrip("."))
    except Exception:
        pass
    parts.append("it is " + time.strftime("%I:%M %p").lstrip("0"))
    return "Here is my status. " + ", and ".join(parts) + "."


def _battery():
    try:
        import ctypes

        class S(ctypes.Structure):
            _fields_ = [("ACLineStatus", ctypes.c_byte), ("BatteryFlag", ctypes.c_byte),
                        ("BatteryLifePercent", ctypes.c_byte), ("SystemStatusFlag", ctypes.c_byte),
                        ("BatteryLifeTime", ctypes.c_ulong), ("BatteryFullLifeTime", ctypes.c_ulong)]
        s = S()
        ctypes.windll.kernel32.GetSystemPowerStatus(ctypes.byref(s))
        plug = " and charging" if s.ACLineStatus == 1 else ""
        return f"Battery is at {s.BatteryLifePercent} percent{plug}."
    except Exception:
        return "I could not read the battery."


# ---------------------------------------------------------------- intents
# (pattern, handler, needs_robot).  Tamil alternatives sit in the same pattern.
INTENTS = [
    # --- head / face ---
    (r"\b(look around|scan (the )?room|சுற்றி\s*பார்)\b", lambda m: _look_around(), True),
    (r"\b(look (to (the )?)?left|இடது\s*பக்கம்\s*பார்)\b",
     lambda m: (robot.pose(EYES_L), "Looking left.")[1], True),
    (r"\b(look (to (the )?)?right|வலது\s*பக்கம்\s*பார்)\b",
     lambda m: (robot.pose(EYES_R), "Looking right.")[1], True),
    (r"\b(look up|மேலே\s*பார்)\b", lambda m: (robot.pose(EYES_UP), "Looking up.")[1], True),
    (r"\b(look down|கீழே\s*பார்)\b", lambda m: (robot.pose(EYES_DOWN), "Looking down.")[1], True),
    (r"\b(look at me|center your eyes|நேராக\s*பார்)\b",
     lambda m: (robot.pose(EYES_C), "Looking at you.")[1], True),
    (r"\b(blink|கண்\s*சிமிட்டு)\b", lambda m: _blink(), True),
    (r"\b(smile|சிரி)\b", lambda m: _expression(SMILE, "Smiling."), True),
    (r"\b(look sad|frown|சோகமா)\b", lambda m: _expression(SAD, "Feeling sad."), True),
    (r"\b(look surprised|surprise|ஆச்சரியம்)\b",
     lambda m: _expression(SURPRISE, "Surprised."), True),
    (r"\b(neutral|relax your face|rest your face|இயல்பு\s*நிலை)\b",
     lambda m: (robot.pose(REST), "Back to neutral.")[1], True),
    (r"\b(stop moving|freeze|outputs off|நிறுத்து)\b",
     lambda m: (robot.off(), "Stopping all movement.")[1], True),
    (r"\b(run (a )?diagnostic|diagnostics|health check|self test|check yourself|சோதனை)\b",
     lambda m: _diagnose(), False),
    (r"\b(status report|system status|how are your systems|report status)\b",
     lambda m: _status_report(), False),

    # --- laptop ---
    (r"\bplay (.+?) on youtube\b", lambda m: _youtube(m.group(1)), False),
    (r"\b(?:search(?: the web)?(?: for)?|google) (.+)$", lambda m: _search_web(m.group(1)), False),
    (r"^type (.+)$", lambda m: _type_text(m.group(1)), False),
    (r"\bopen (?:the )?(.+?)(?: app| program)?\s*$", lambda m: _open_app(m.group(1)), False),
    (r"\bclose (?:(?:this|that|the)(?: current)? )?window\b", lambda m: _close_window(), False),
    (r"\bclose (?:the )?(.+?)(?: app| program)?\s*$", lambda m: _close_app(m.group(1)), False),
    (r"\b(pause|stop the (music|song|video)|play the (music|song|video)|play music|resume the (music|song))\b",
     lambda m: _media(179, "Done."), False),
    (r"\b(next (song|track)|skip (this )?(song|track))\b", lambda m: _media(176, "Next track."), False),
    (r"\b(previous (song|track)|last song|go back a (song|track))\b",
     lambda m: _media(177, "Previous track."), False),
    (r"\b(volume up|louder|turn it up|சத்தம்\s*அதிகரி)\b", lambda m: _volume("up"), False),
    (r"\b(volume down|quieter|turn it down|சத்தம்\s*குறை)\b", lambda m: _volume("down"), False),
    (r"\b(mute|unmute|silence)\b", lambda m: _volume("mute"), False),
    (r"\b(brightness up|brighter|increase (the )?brightness)\b", lambda m: _brightness(20), False),
    (r"\b(brightness down|dimmer|reduce (the )?brightness|decrease (the )?brightness)\b",
     lambda m: _brightness(-20), False),
    (r"\b(minimize (everything|all( (the )?windows)?)|show (me )?(the )?desktop)\b",
     lambda m: _minimize_all(), False),
    (r"\b(take a )?screenshot\b", lambda m: _screenshot(), False),
    (r"\b(lock (the )?(screen|laptop|computer))\b",
     lambda m: (_run(["rundll32.exe", "user32.dll,LockWorkStation"]), "Locking the screen.")[1], False),
    (r"\b(go to sleep|sleep now|sleep (the )?(laptop|computer|pc))\b",
     lambda m: _sleep_pc(), False),
    (r"\bcancel (the )?(shutdown|restart)\b", lambda m: _power("cancel"), False),
    (r"\bshut ?down\b", lambda m: _power("off"), False),
    (r"\brestart (the )?(laptop|computer|pc)\b", lambda m: _power("restart"), False),
    (r"\b(disk space|free space|storage (left|space))\b", lambda m: _disk_space(), False),
    (r"\b(ip address|my ip)\b", lambda m: _my_ip(), False),
    (r"\b(battery|charge level|பேட்டரி)\b", lambda m: _battery(), False),
    (r"\bwhat(?:'s| is)? the time|what time is it|நேரம்\s*என்ன\b",
     lambda m: "It is " + time.strftime("%I:%M %p").lstrip("0") + ".", False),
    (r"\bwhat(?:'s| is)? (?:today'?s )?(?:date|day)|what day is it|என்ன\s*தேதி\b",
     lambda m: "Today is " + time.strftime("%A, %d %B %Y") + ".", False),
]
COMPILED = [(re.compile(p, re.IGNORECASE), fn, needs) for p, fn, needs in INTENTS]


def match(text):
    """Return (reply, name) if this is a command, else (None, None).

    Runs before the LLM, so commands never pay model latency.
    """
    t = " ".join(text.split())
    for rx, fn, needs_robot in COMPILED:
        m = rx.search(t)
        if not m:
            continue
        if needs_robot and not robot.available:
            return ("My body is not connected yet, so I cannot move. "
                    "Enable motion once the servos are calibrated."), "blocked"
        try:
            return fn(m), rx.pattern[:28]
        except Exception as e:
            return f"I tried, but something went wrong: {str(e)[:60]}", "error"
    return None, None


def describe():
    return {
        "robot": ["look around", "look left / right / up / down", "look at me",
                  "blink", "smile", "look sad", "look surprised", "neutral",
                  "stop moving"],
        "laptop": ["open notepad / chrome / youtube / gmail / whatsapp / news",
                   "search for <anything>", "play <song> on youtube",
                   "type <text>", "pause / next song / previous song",
                   "volume up / down / mute", "brightness up / down",
                   "screenshot", "minimize everything", "close chrome / notepad",
                   "lock the screen", "go to sleep",
                   "shutdown / restart the laptop / cancel shutdown",
                   "disk space", "battery", "my ip",
                   "run diagnostics", "status report",
                   "what time is it", "what is the date"],
        "motion_enabled": robot.available,
    }
