uk-ux/inmoov-iris/(commit log)

2026-09-29 Initial import: InMoov IRIS head — control UI, voice stack, firmware, hardware docs
    [BottomTeethV1-part0.stl, BottomTeethV1.stl, CheekPullerV3-part0.stl, CheekPullerV3-part1.stl, CheekPullerV3.stl, EarLockV1-part0.stl, EarLockV1-part1.stl, EarLockV1.stl]
2026-09-29 Fix tab panel visibility bug and polish orb UI
    - panel-fill display:flex was overriding the hidden attribute, so all
    four console tabs rendered stacked at once
    - complete the date block (day/month/weekday elements existed in CSS+JS
    but not in HTML)
    - proper offline state: blinking status dot, red VOICE LINK OFFLINE
    caption, disabled composer and hands-free button
    - HUD-style timestamps on chat messages
    - consistent uppercase talk-button labels
